TheByteAttic/CERBERUS2080/Photos/IMG_0653.jpeg

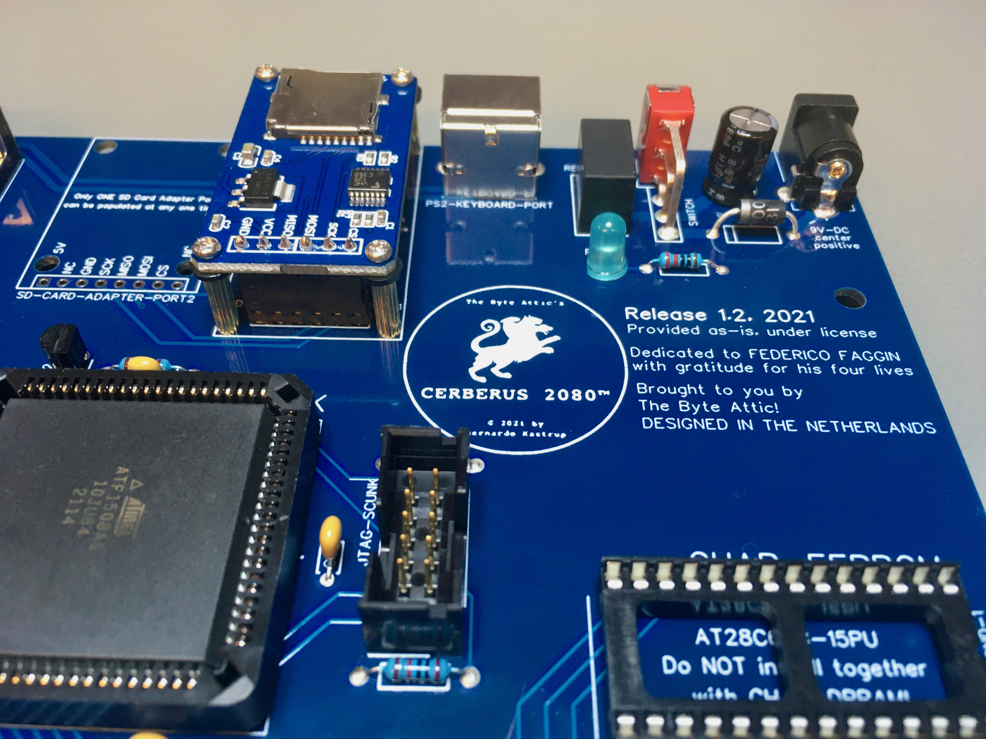
Photos/IMG_0653.jpeg
