TheByteAttic/CERBERUS2080/Photos/IMG_0697.jpg

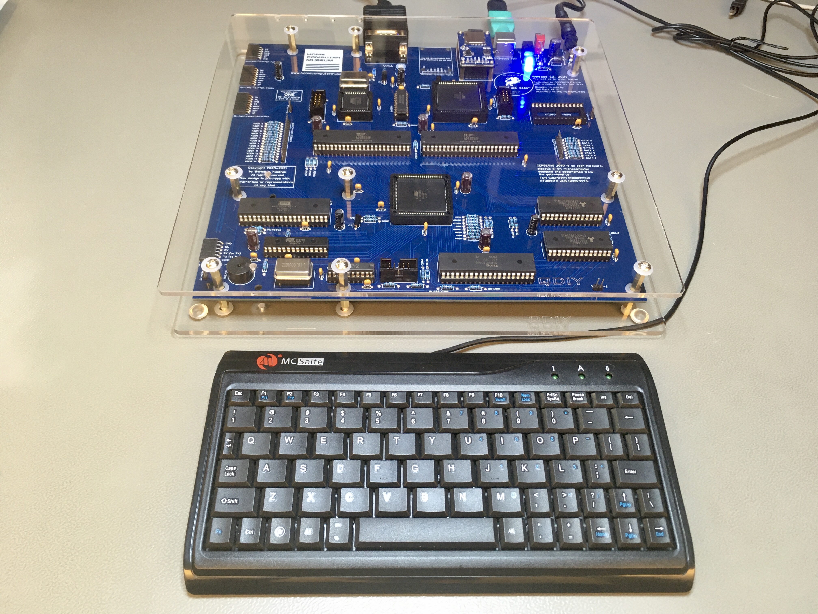
Photos/IMG_0697.jpg
