TheByteAttic/CERBERUS2080/CERBERUS Applications Source Code/README.md

This directory contains the source files (.asm) and final binary files (.bin) simple applications that runs on both of CERBERUS's CPUs (one version per CPU). 

They illustrate how to go from assembly code to binary, in a way that CERBERUS's simple loader can deal with.
