TheByteAttic/CERBERUS2080/Photos/README.md

Photos of a correctly-assembled CERBERUS, including many detail pictures. These could provide a reference for those building their own CERBERUS.
<hr>
<b>CHANGE HISTORY:</b>
<p>
<ul>
  <li><b>10 September 2021:</b> Photos of the original board (R1.0) replaced with those of the latest release (R1.2).</li>
</ul>
