TheByteAttic/CERBERUS2080/CERBERUS uSD card files/README.md

These are the files you should load into a uSD card and then insert the card into the uSD card adapter of CERBERUS 2080™ prior to powering it on.
