TheByteAttic/CERBERUS2080/Photos/IMG_0616.jpeg

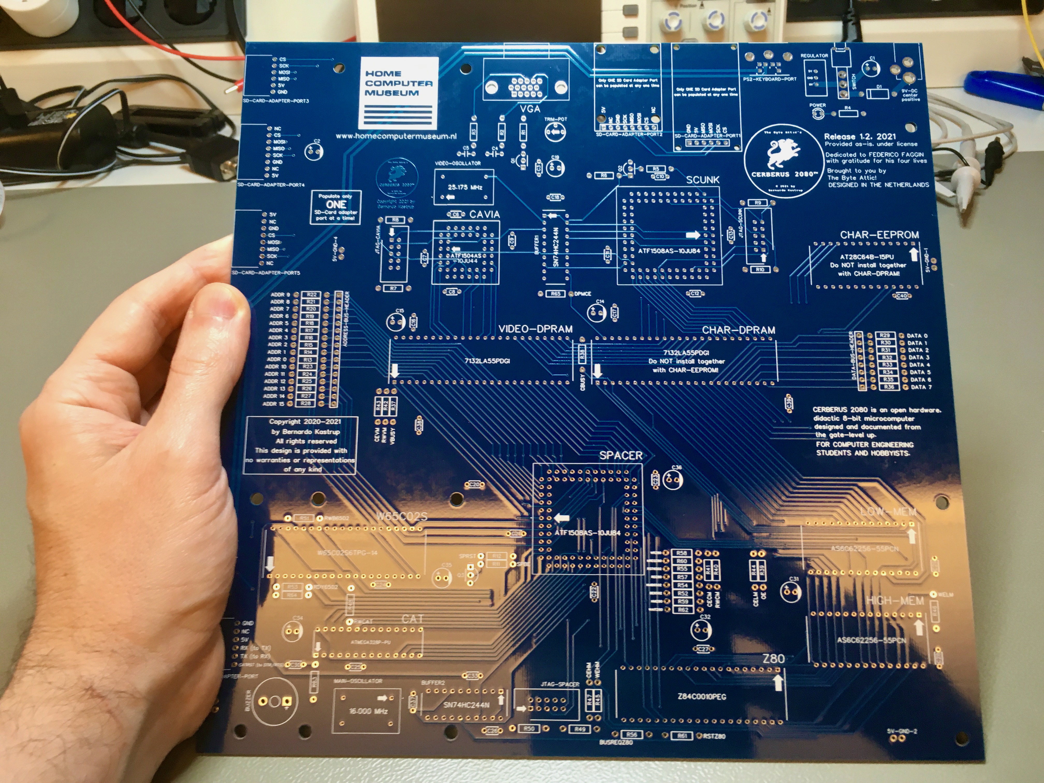
Photos/IMG_0616.jpeg
