TheByteAttic/CERBERUS2080/Photos/IMG_0617.jpeg

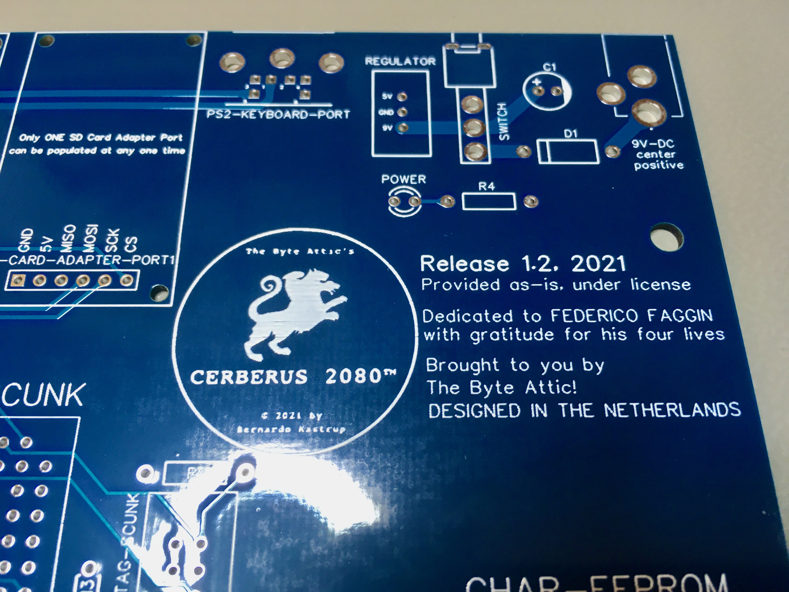
Photos/IMG_0617.jpeg
