TheByteAttic/CERBERUS2080/Photos/IMG_0618.jpeg

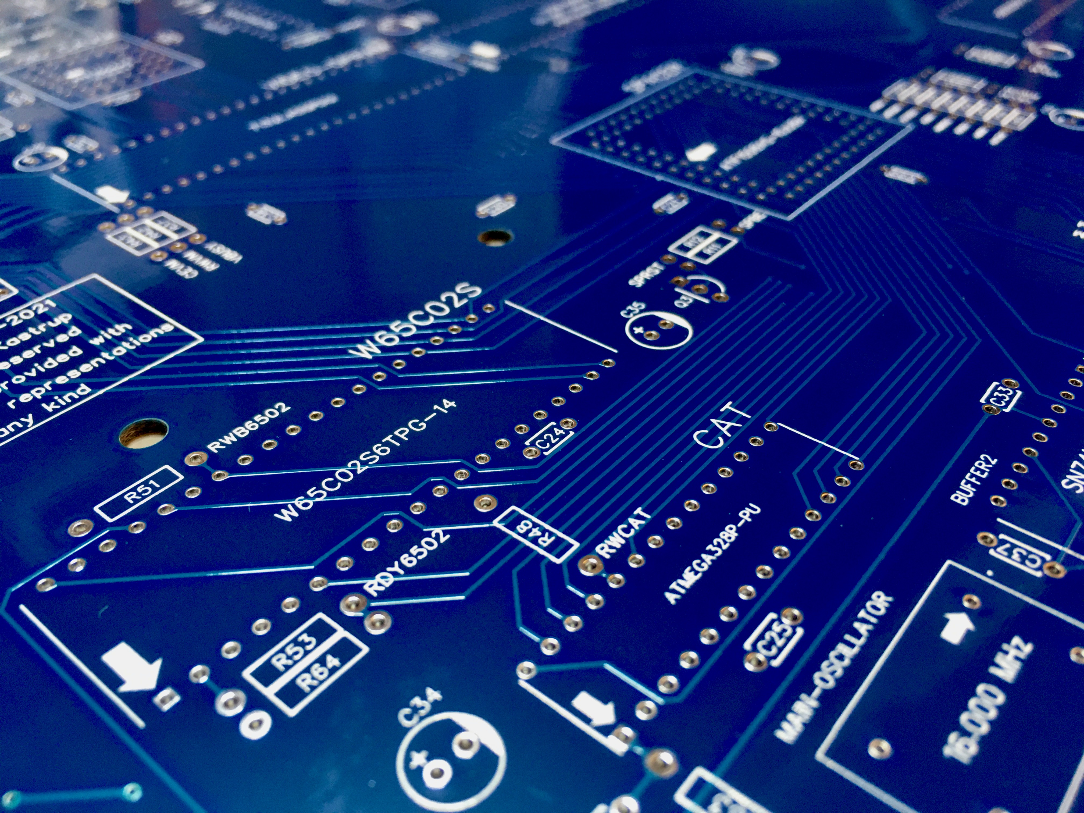
Photos/IMG_0618.jpeg
