TheByteAttic/CERBERUS2080/Photos/IMG_0619.jpeg

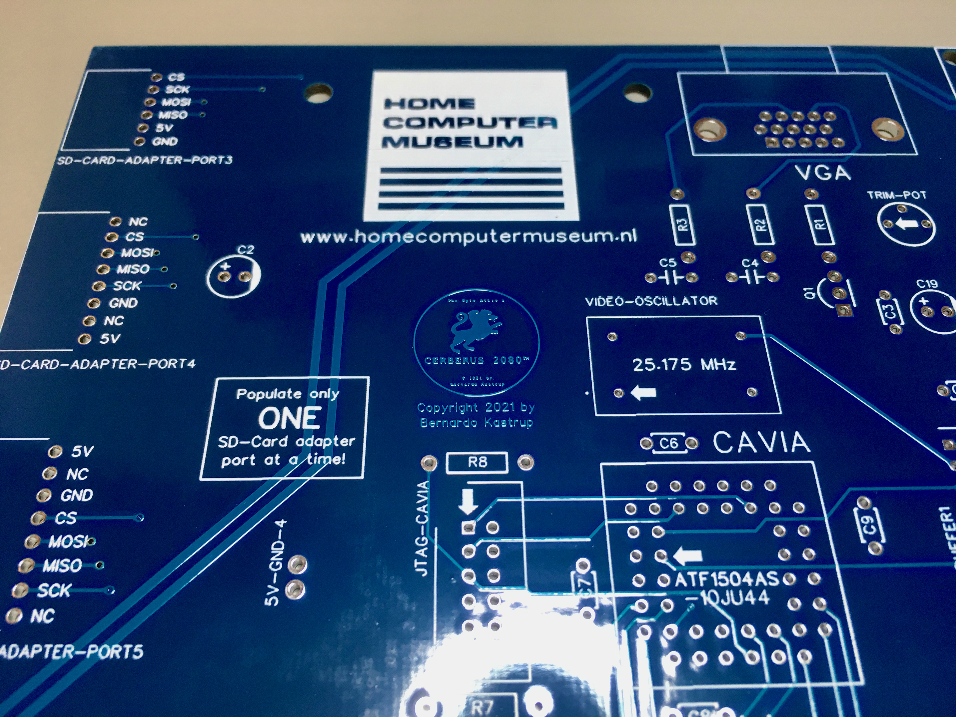
Photos/IMG_0619.jpeg
