TheByteAttic/CERBERUS2080/Photos/IMG_0620.jpeg

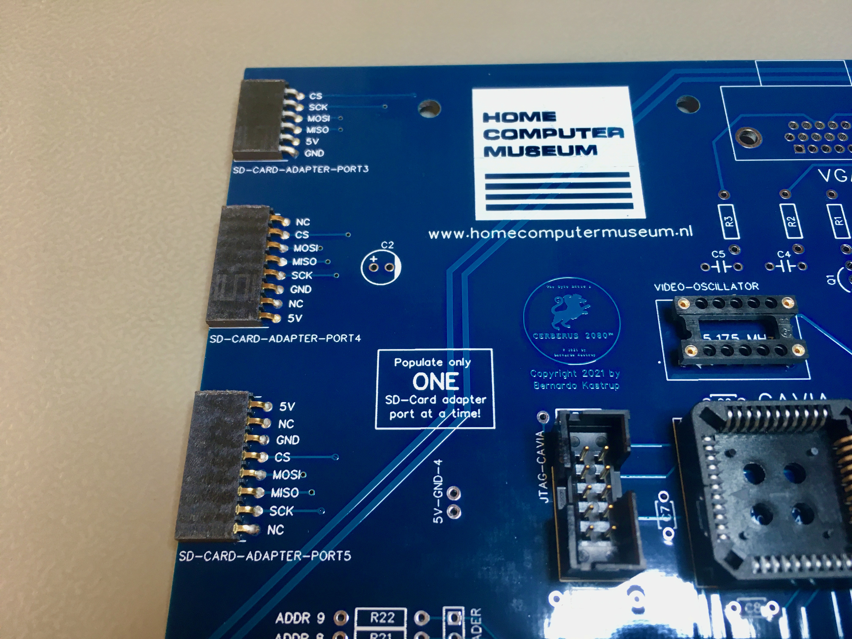
Photos/IMG_0620.jpeg
