TheByteAttic/CERBERUS2080/Photos/IMG_0621.jpeg

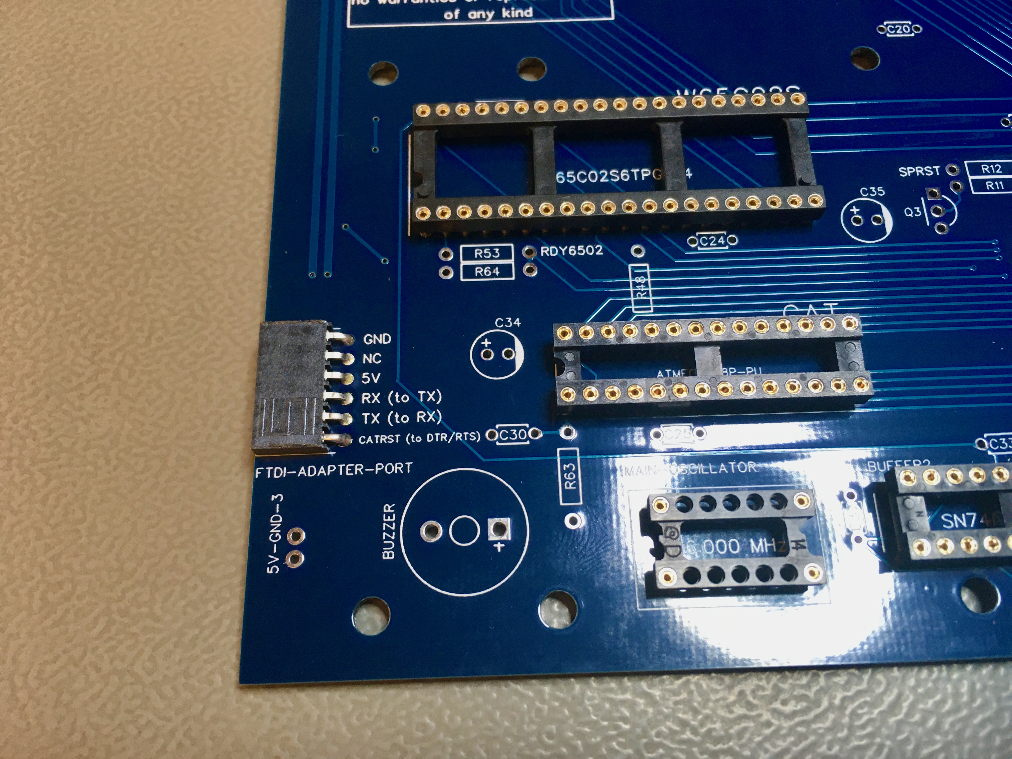
Photos/IMG_0621.jpeg
