TheByteAttic/CERBERUS2080/Photos/IMG_0622.jpeg

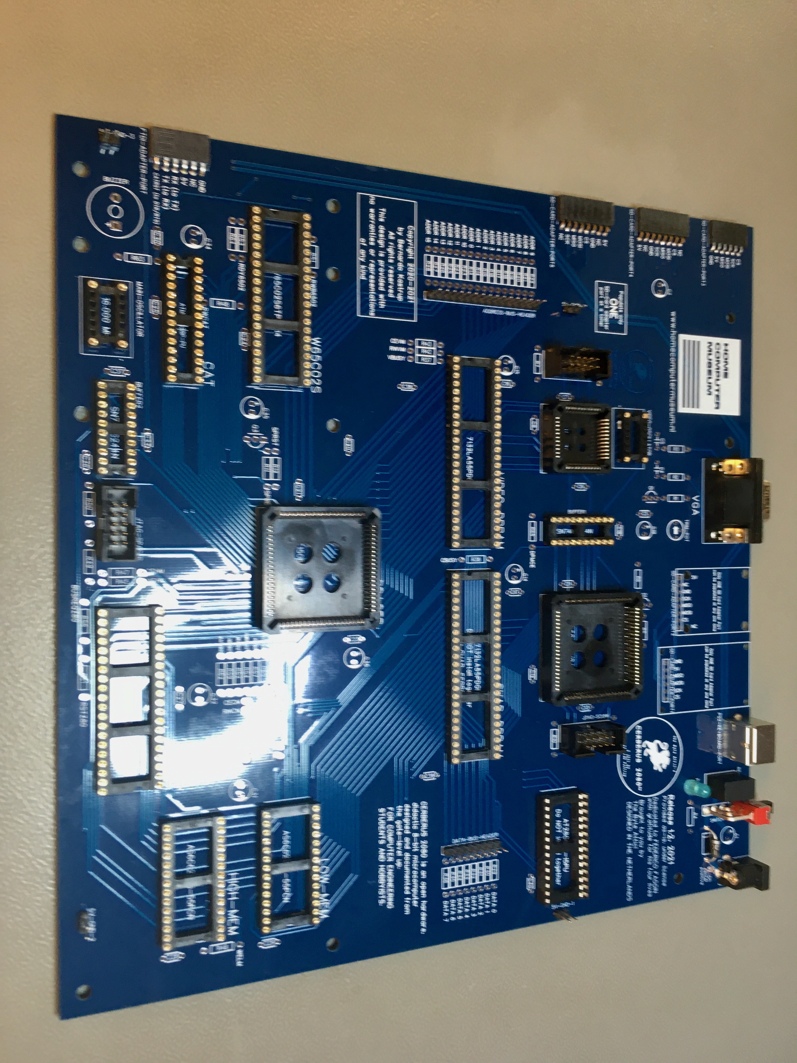
Photos/IMG_0622.jpeg
