TheByteAttic/CERBERUS2080/Photos/IMG_0623.jpeg

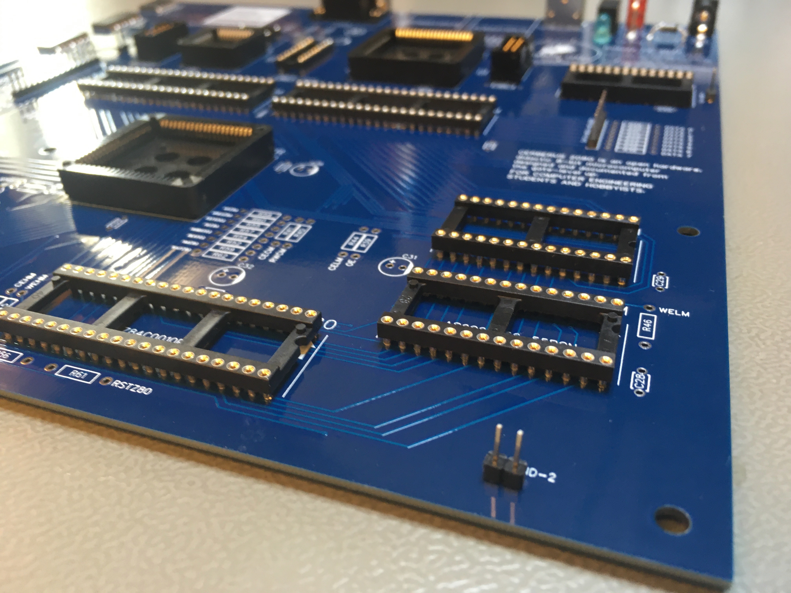
Photos/IMG_0623.jpeg
