TheByteAttic/CERBERUS2080/Photos/IMG_0627.jpeg

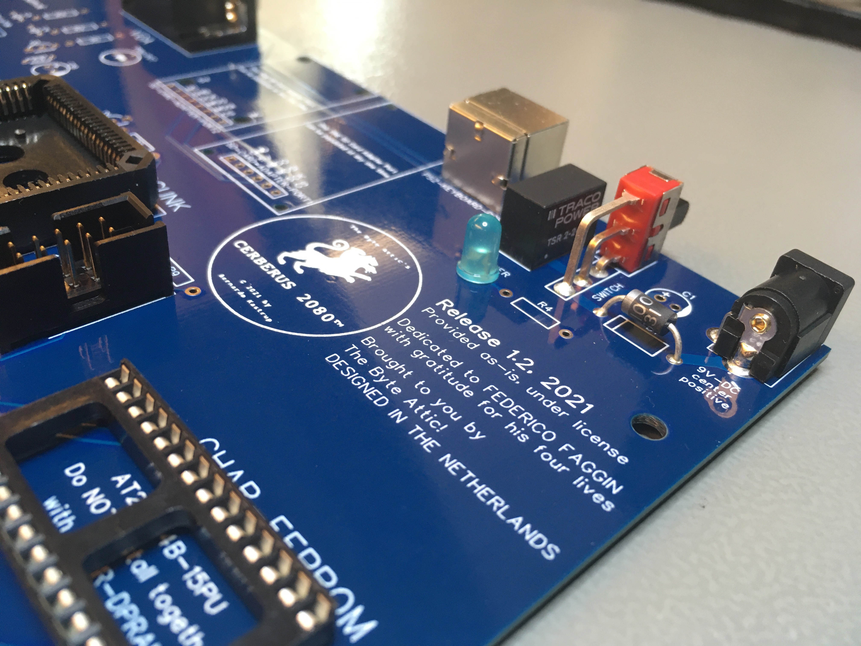
Photos/IMG_0627.jpeg
