TheByteAttic/CERBERUS2080/Photos/IMG_0628.jpeg

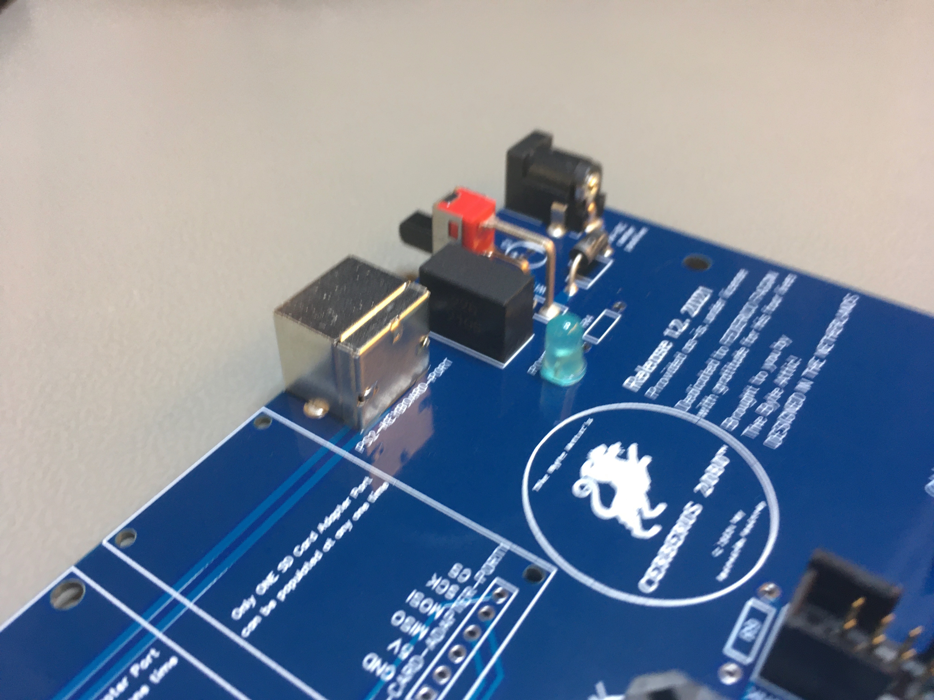
Photos/IMG_0628.jpeg
