TheByteAttic/CERBERUS2080/Photos/IMG_0629.jpeg

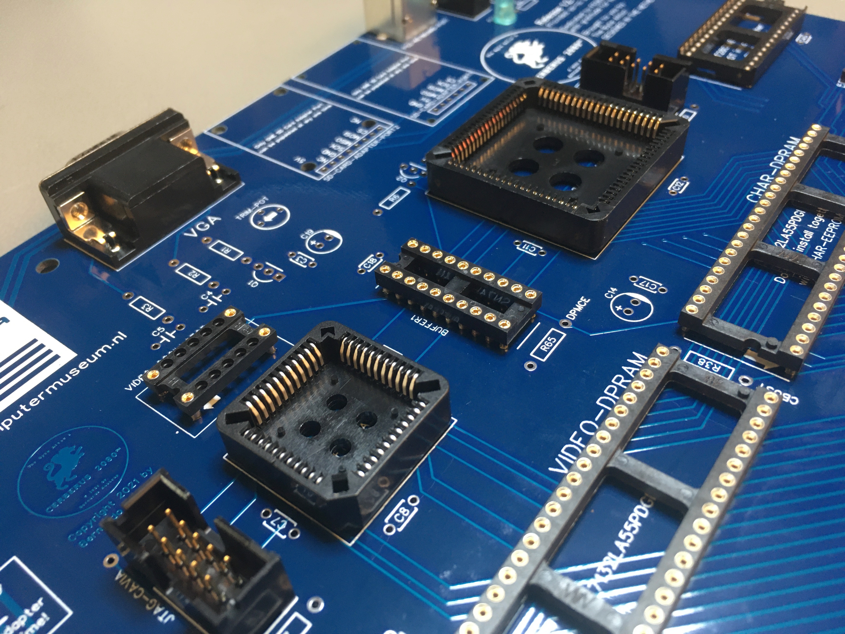
Photos/IMG_0629.jpeg
