TheByteAttic/CERBERUS2080/Photos/IMG_0630.jpeg

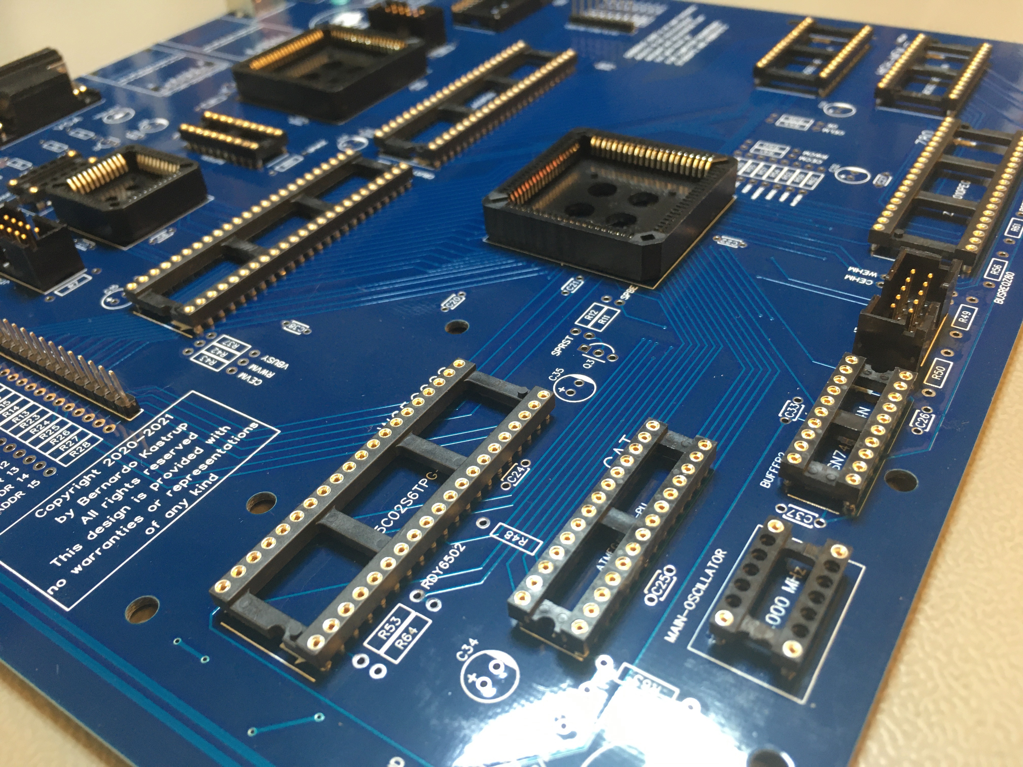
Photos/IMG_0630.jpeg
