TheByteAttic/CERBERUS2080/Photos/IMG_0631.jpeg

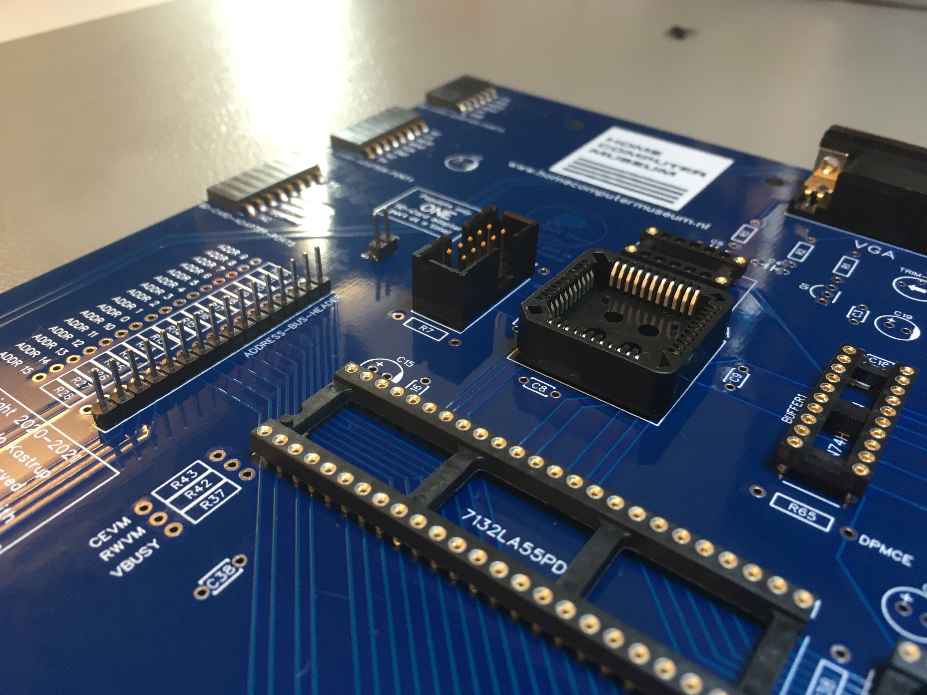
Photos/IMG_0631.jpeg
