TheByteAttic/CERBERUS2080/Photos/IMG_0632.jpeg

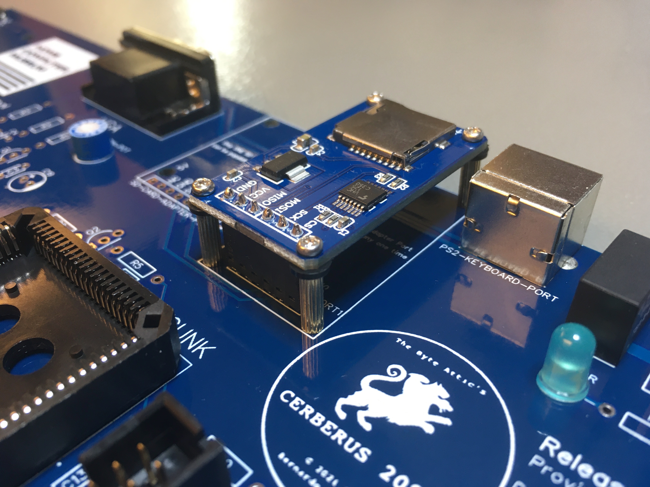
Photos/IMG_0632.jpeg
