TheByteAttic/CERBERUS2080/Photos/IMG_0633.jpeg

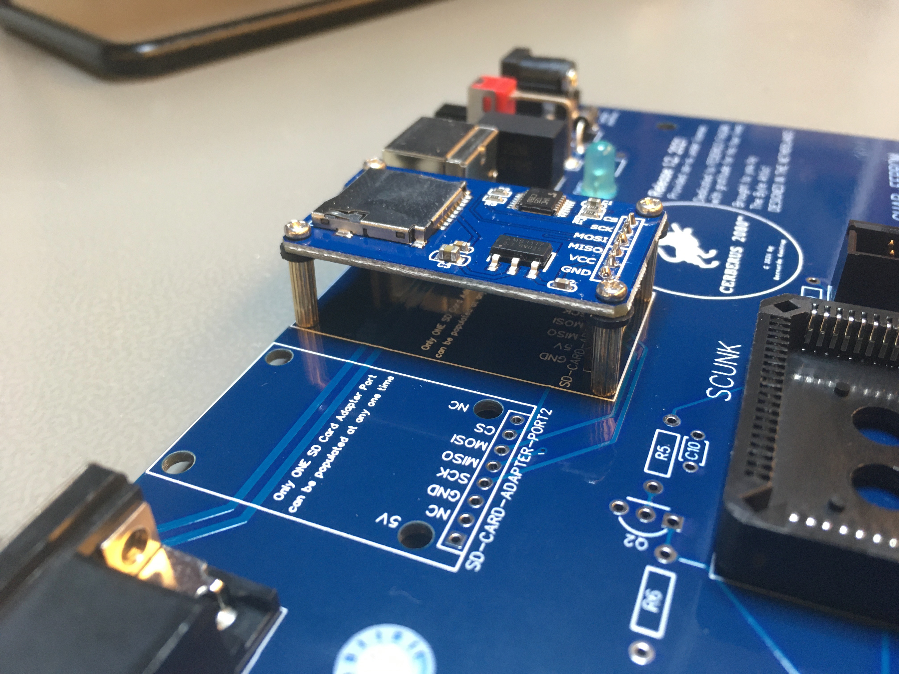
Photos/IMG_0633.jpeg
