TheByteAttic/CERBERUS2080/Photos/IMG_0634.jpeg

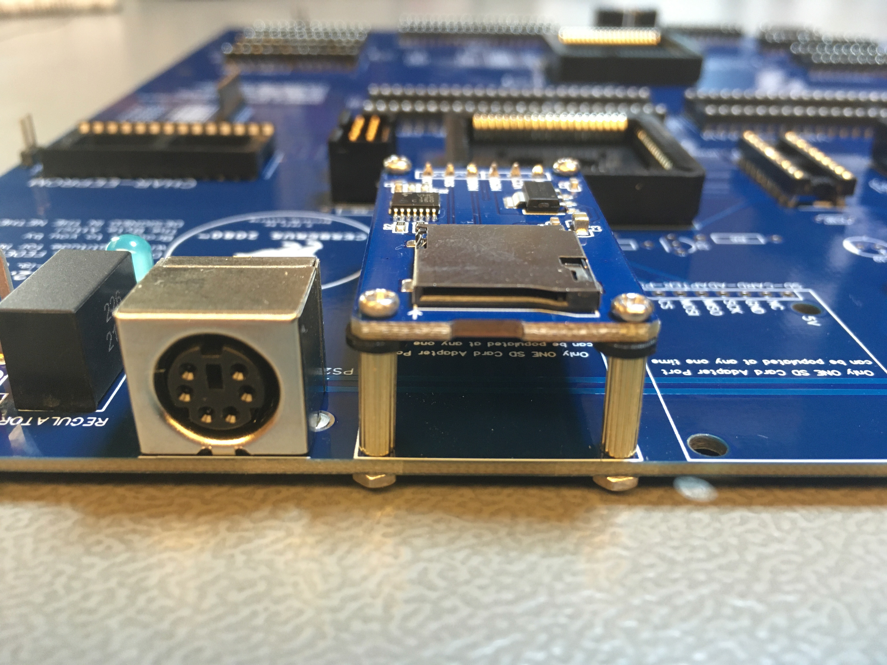
Photos/IMG_0634.jpeg
