TheByteAttic/CERBERUS2080/Photos/IMG_0635.jpeg

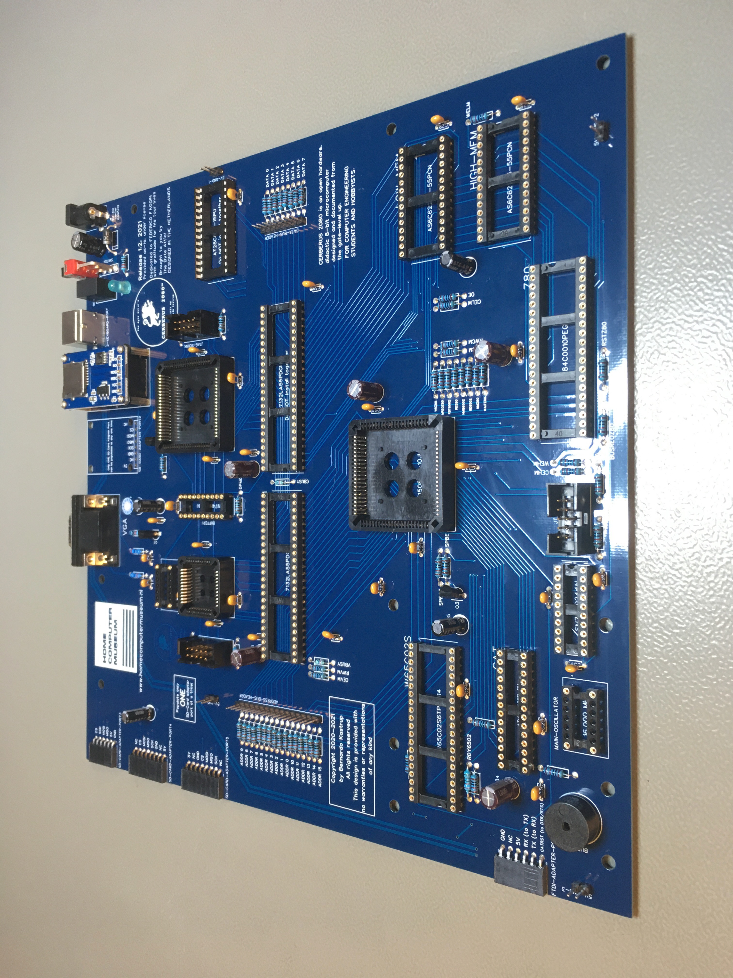
Photos/IMG_0635.jpeg
