TheByteAttic/CERBERUS2080/Photos/IMG_0636.jpeg

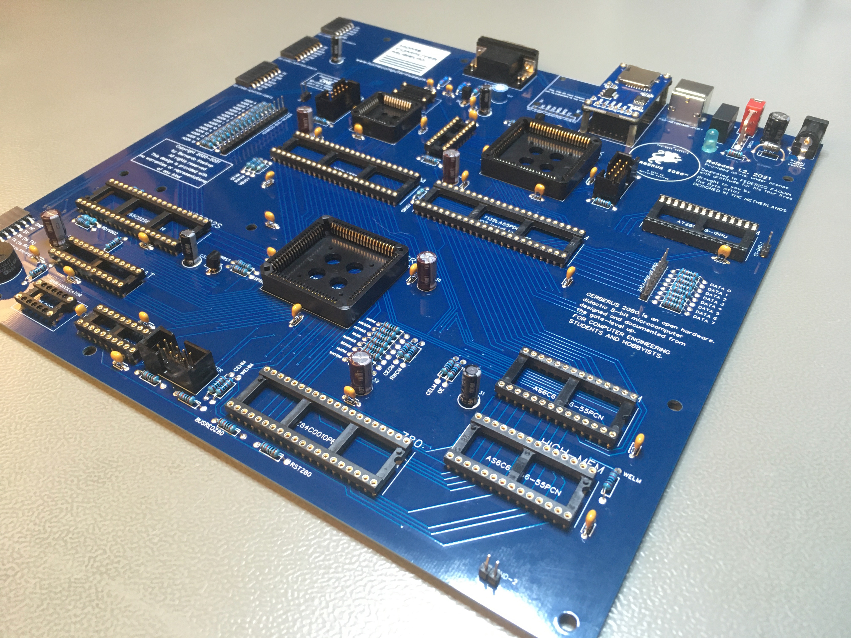
Photos/IMG_0636.jpeg
