TheByteAttic/CERBERUS2080/Photos/IMG_0637.jpeg

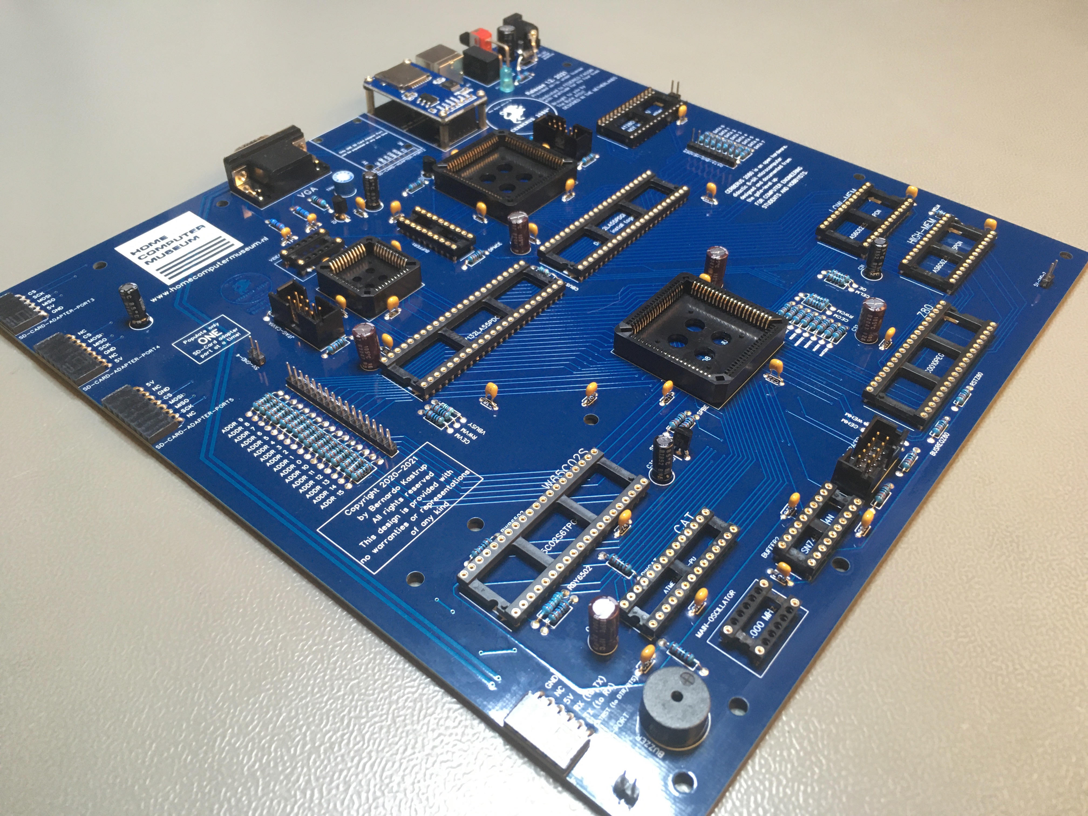
Photos/IMG_0637.jpeg
