TheByteAttic/CERBERUS2080/Photos/IMG_0638.jpeg

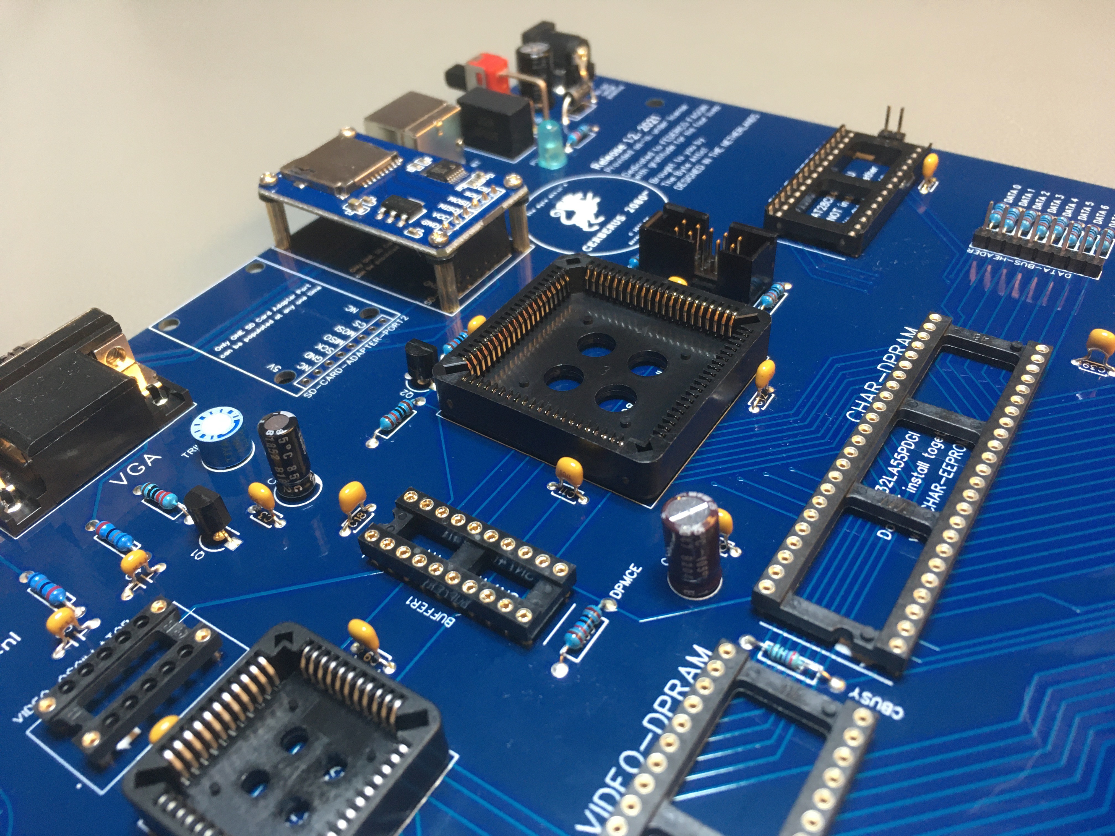
Photos/IMG_0638.jpeg
