TheByteAttic/CERBERUS2080/Photos/IMG_0639.jpeg

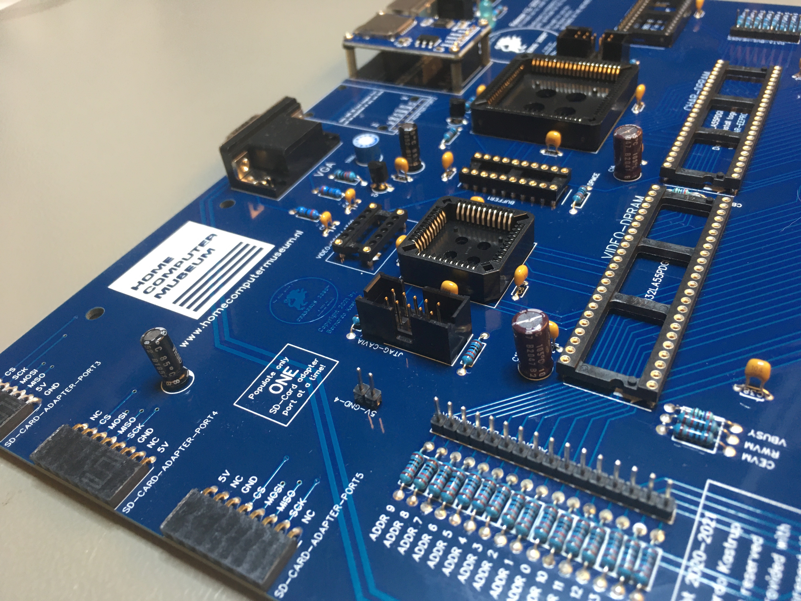
Photos/IMG_0639.jpeg
