TheByteAttic/CERBERUS2080/Photos/IMG_0640.jpeg

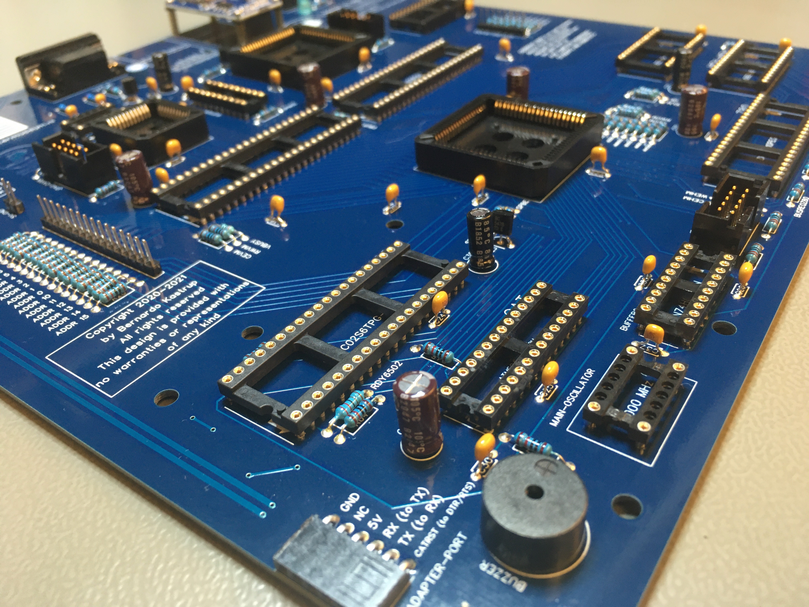
Photos/IMG_0640.jpeg
