TheByteAttic/CERBERUS2080/Photos/IMG_0641.jpeg

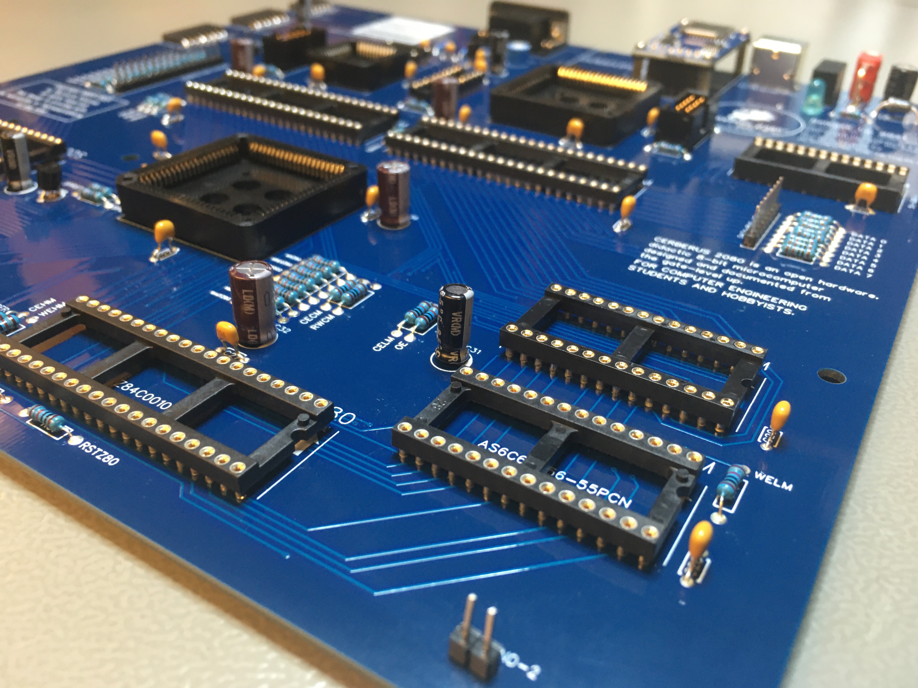
Photos/IMG_0641.jpeg
