TheByteAttic/CERBERUS2080/Photos/IMG_0642.jpeg

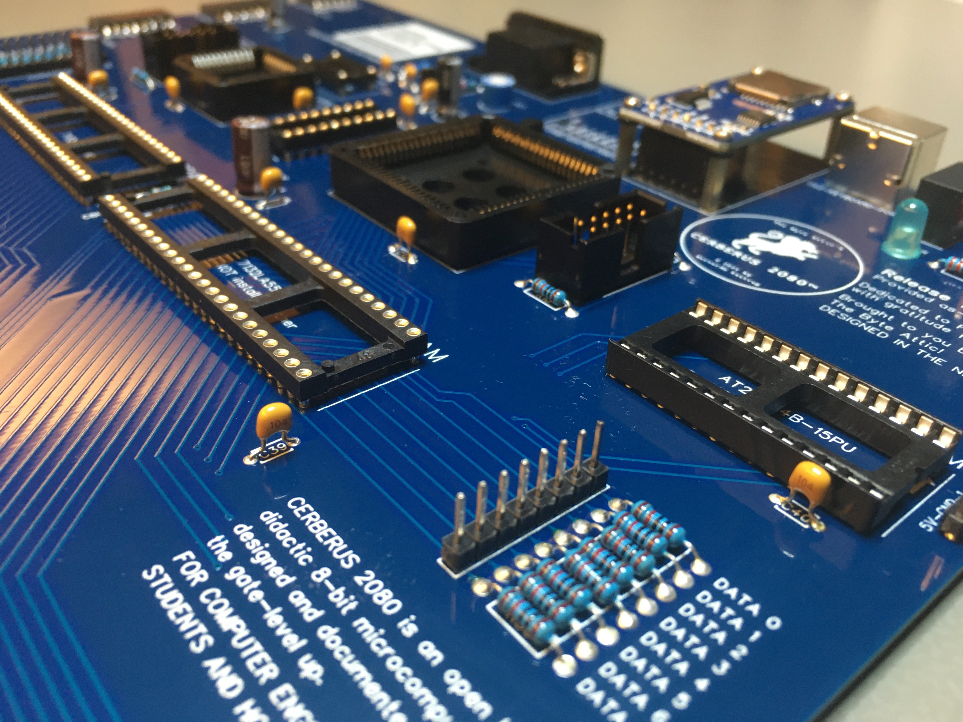
Photos/IMG_0642.jpeg
