TheByteAttic/CERBERUS2080/Photos/IMG_0643.jpeg

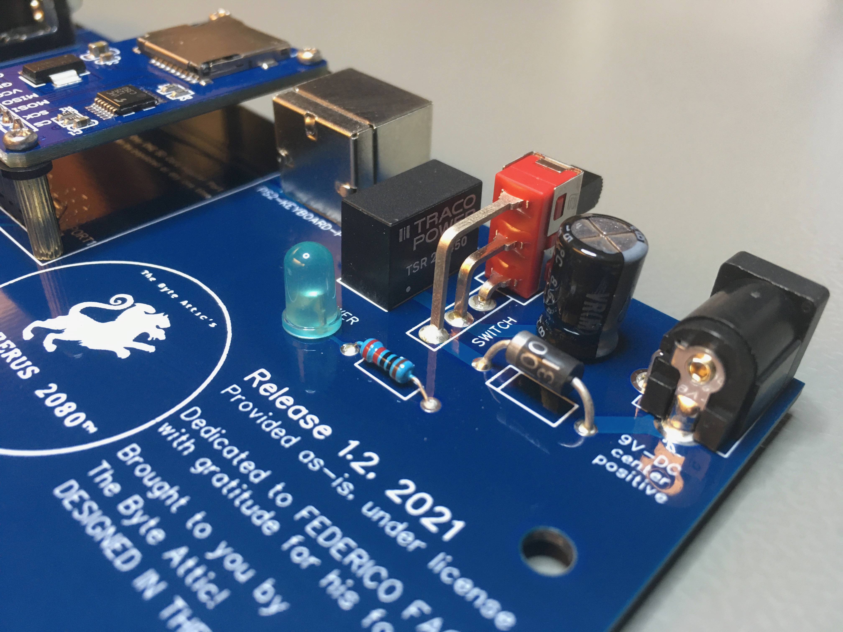
Photos/IMG_0643.jpeg
