TheByteAttic/CERBERUS2080/Photos/IMG_0644.jpeg

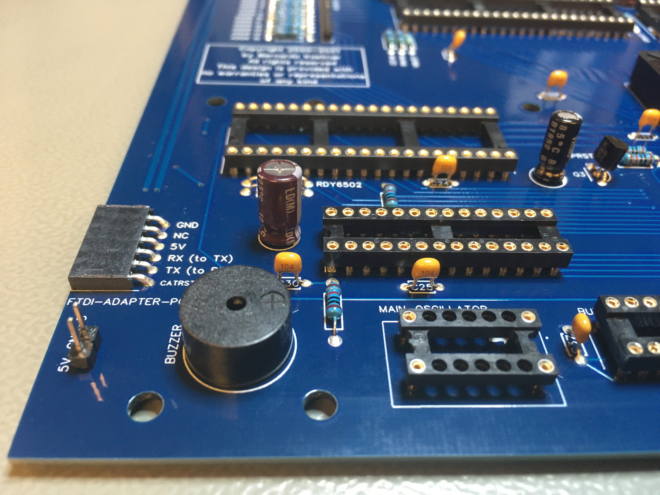
Photos/IMG_0644.jpeg
