TheByteAttic/CERBERUS2080/Photos/IMG_0645.jpeg

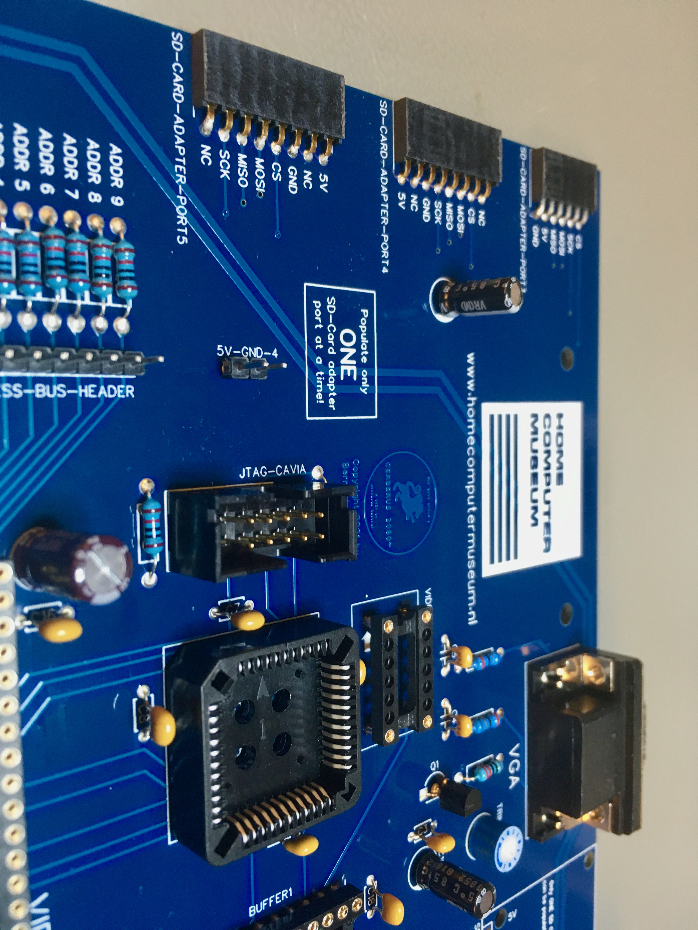
Photos/IMG_0645.jpeg
