TheByteAttic/CERBERUS2080/Photos/IMG_0646.jpeg

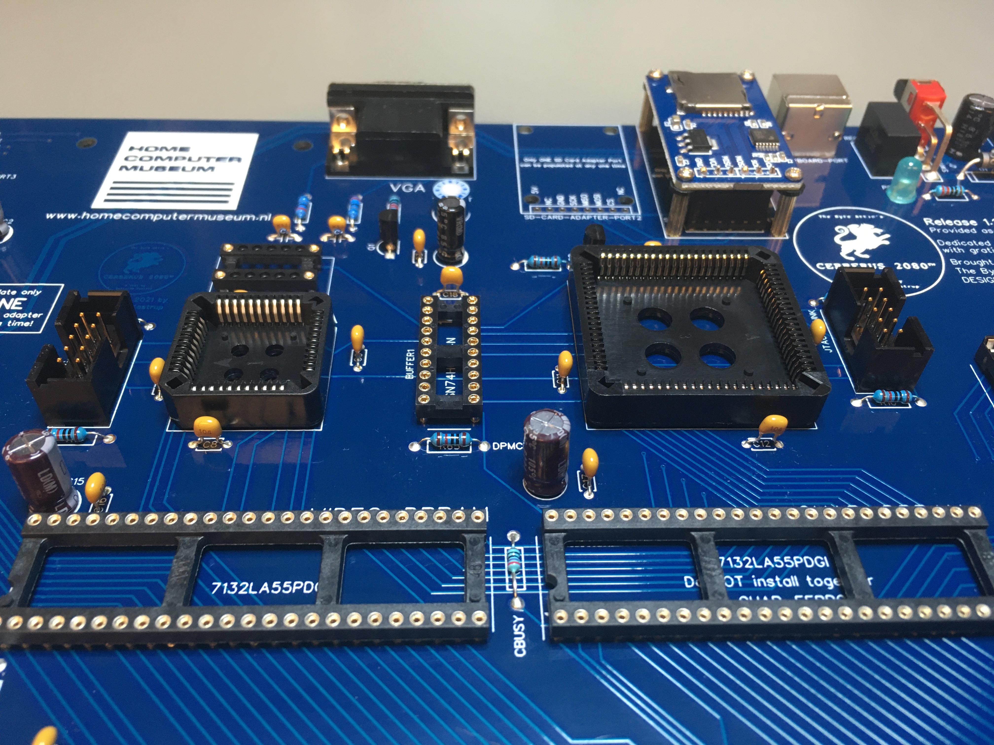
Photos/IMG_0646.jpeg
