TheByteAttic/CERBERUS2080/Photos/IMG_0647.jpeg

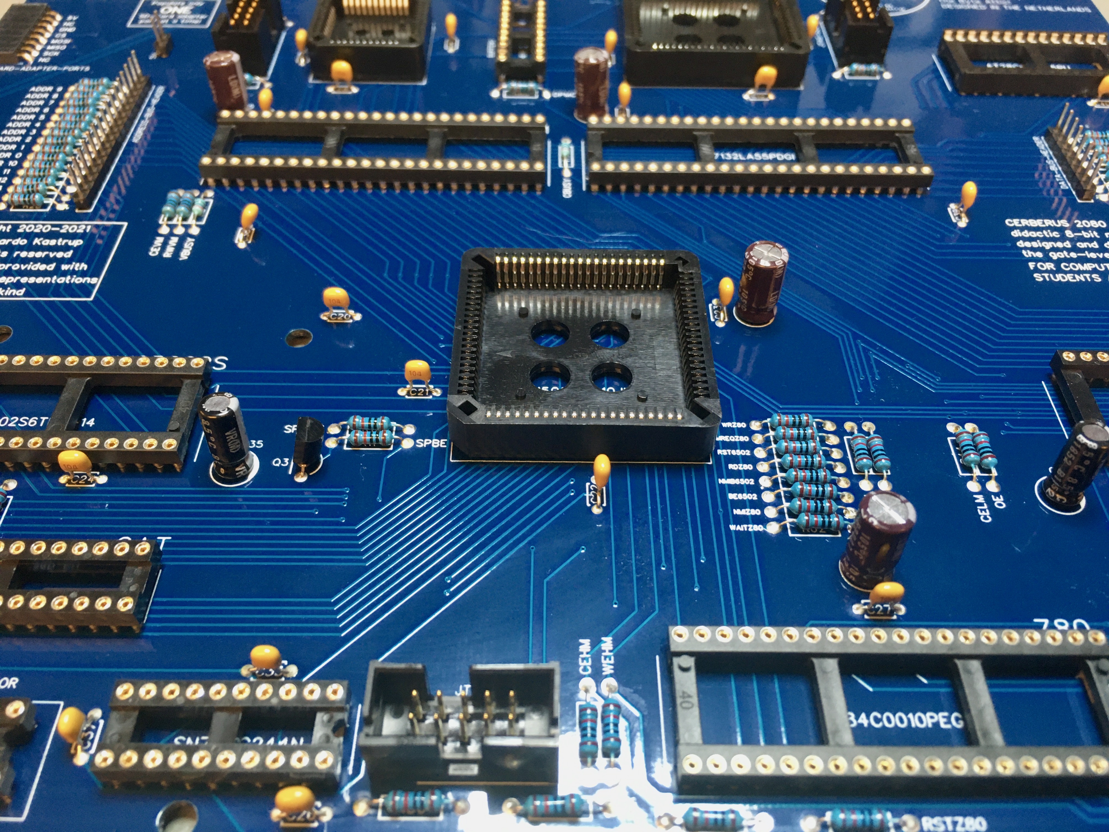
Photos/IMG_0647.jpeg
