TheByteAttic/CERBERUS2080/Photos/IMG_0648.jpeg

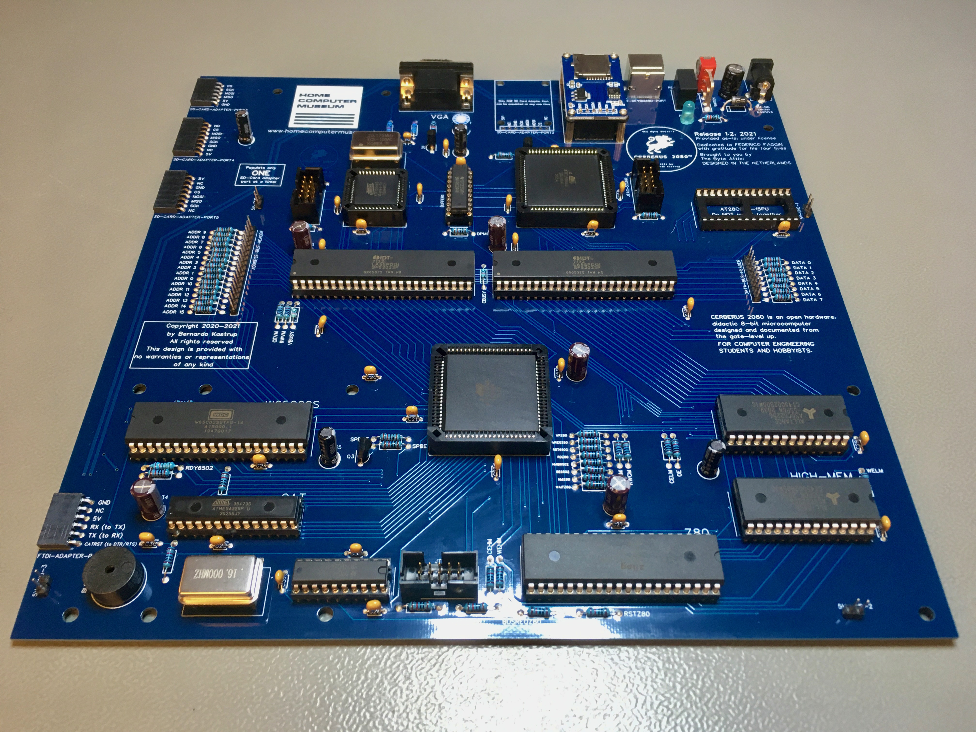
Photos/IMG_0648.jpeg
