TheByteAttic/CERBERUS2080/Photos/IMG_0649.jpeg

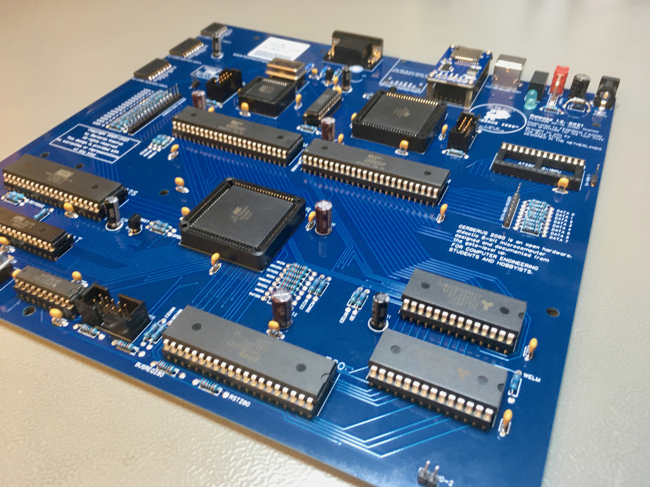
Photos/IMG_0649.jpeg
