TheByteAttic/CERBERUS2080/Photos/IMG_0650.jpeg

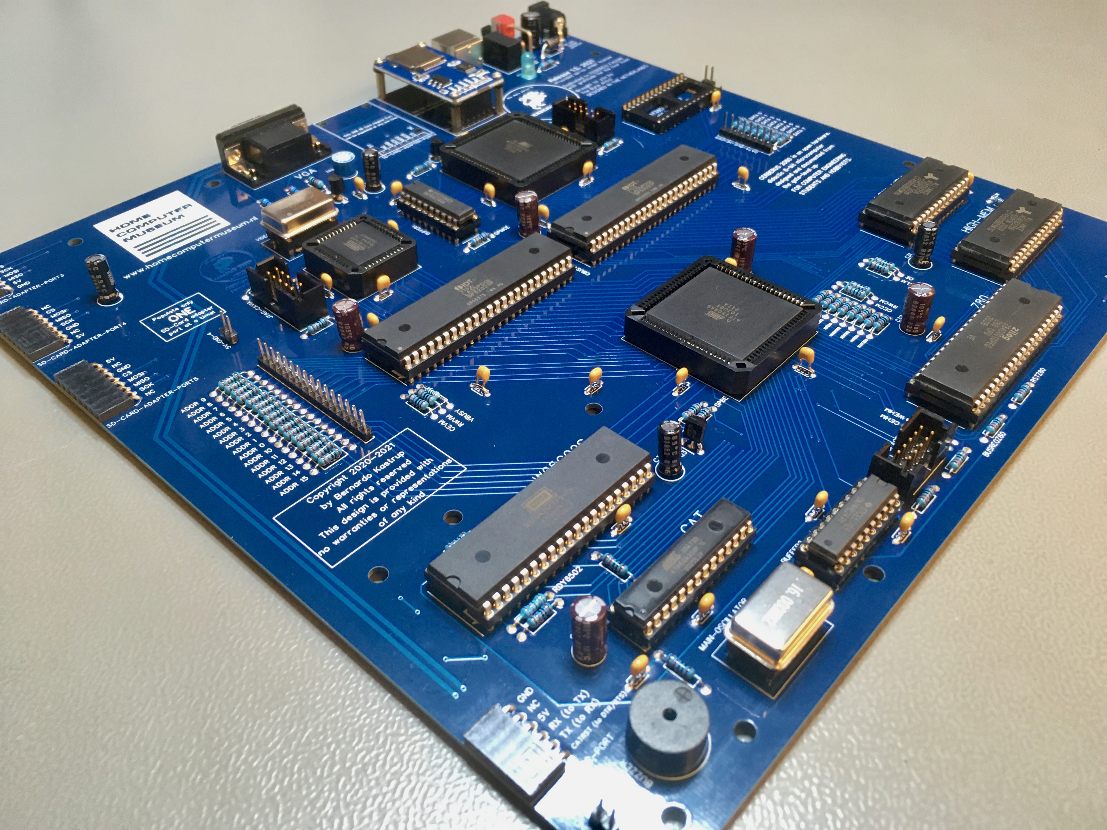
Photos/IMG_0650.jpeg
