TheByteAttic/CERBERUS2080/Photos/IMG_0651.jpeg

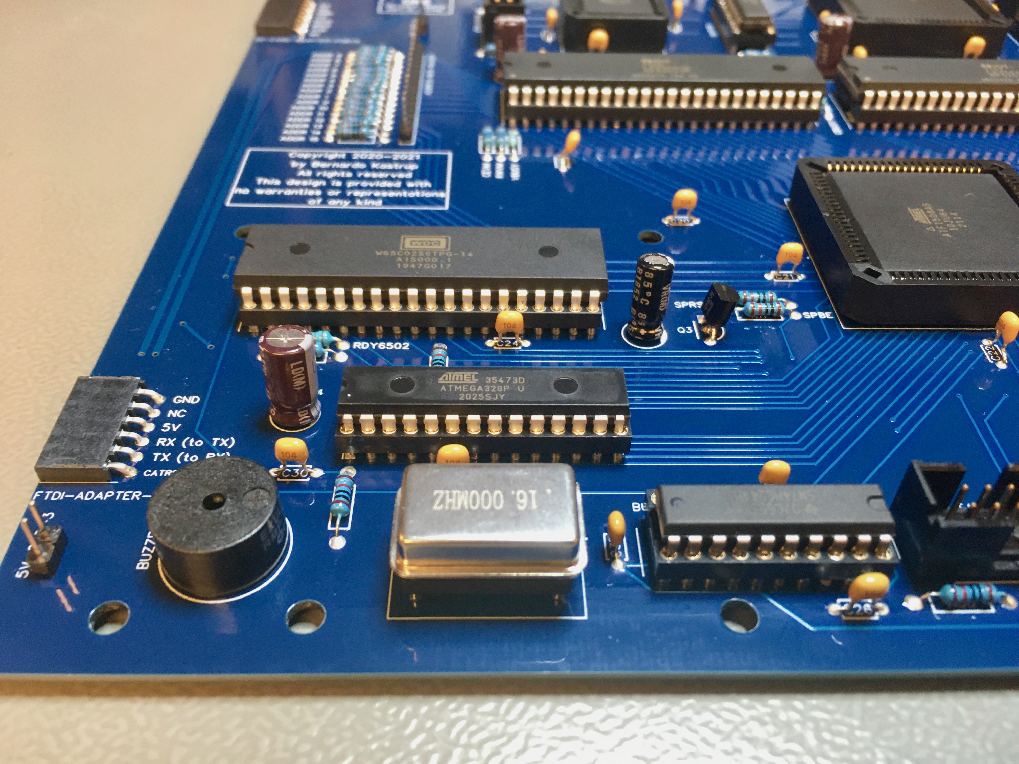
Photos/IMG_0651.jpeg
