TheByteAttic/CERBERUS2080/Photos/IMG_0652.jpeg

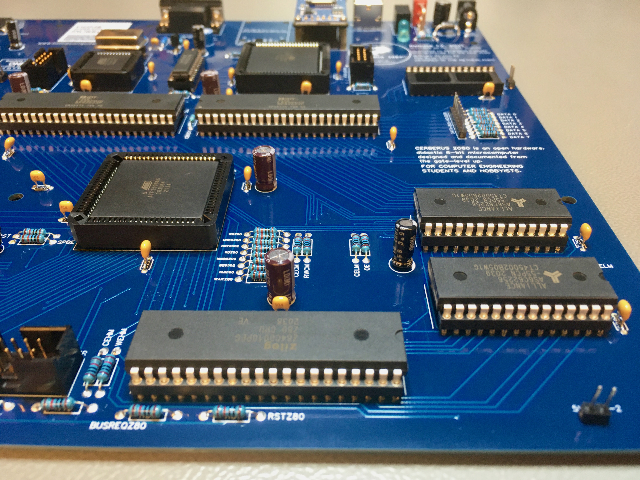
Photos/IMG_0652.jpeg
