TheByteAttic/CERBERUS2080/Photos/IMG_0654.jpeg

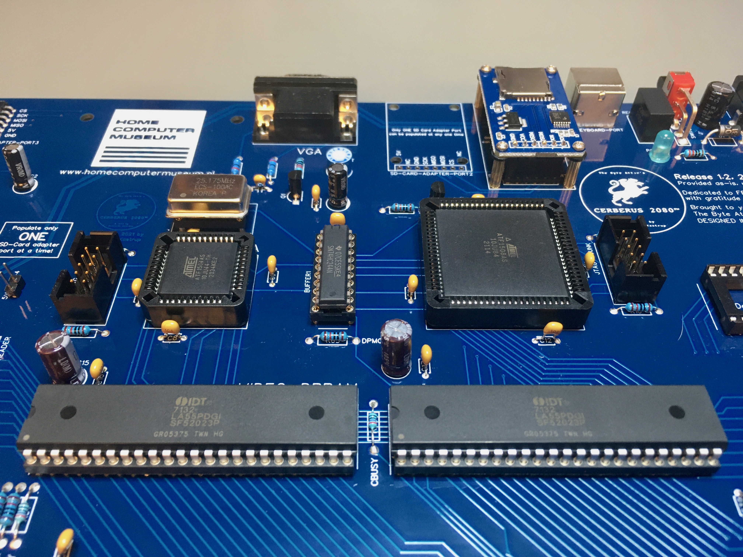
Photos/IMG_0654.jpeg
