TheByteAttic/CERBERUS2080/Photos/IMG_0655.jpeg

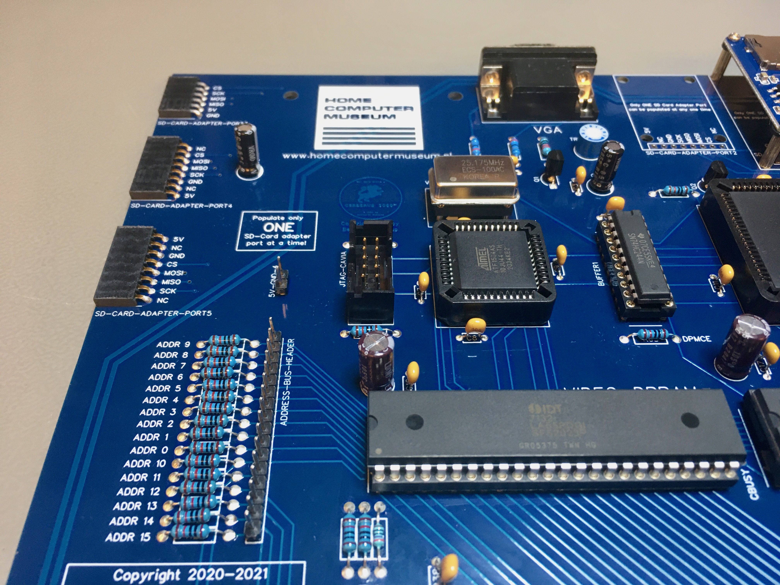
Photos/IMG_0655.jpeg
