TheByteAttic/CERBERUS2080/Photos/IMG_0656.jpeg

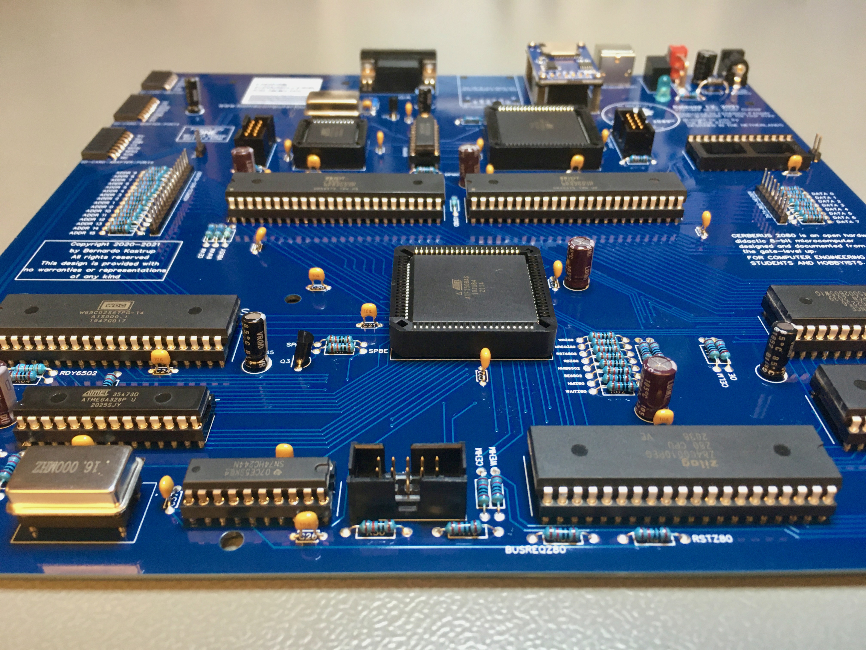
Photos/IMG_0656.jpeg
