TheByteAttic/CERBERUS2080/Photos/IMG_0657.jpeg

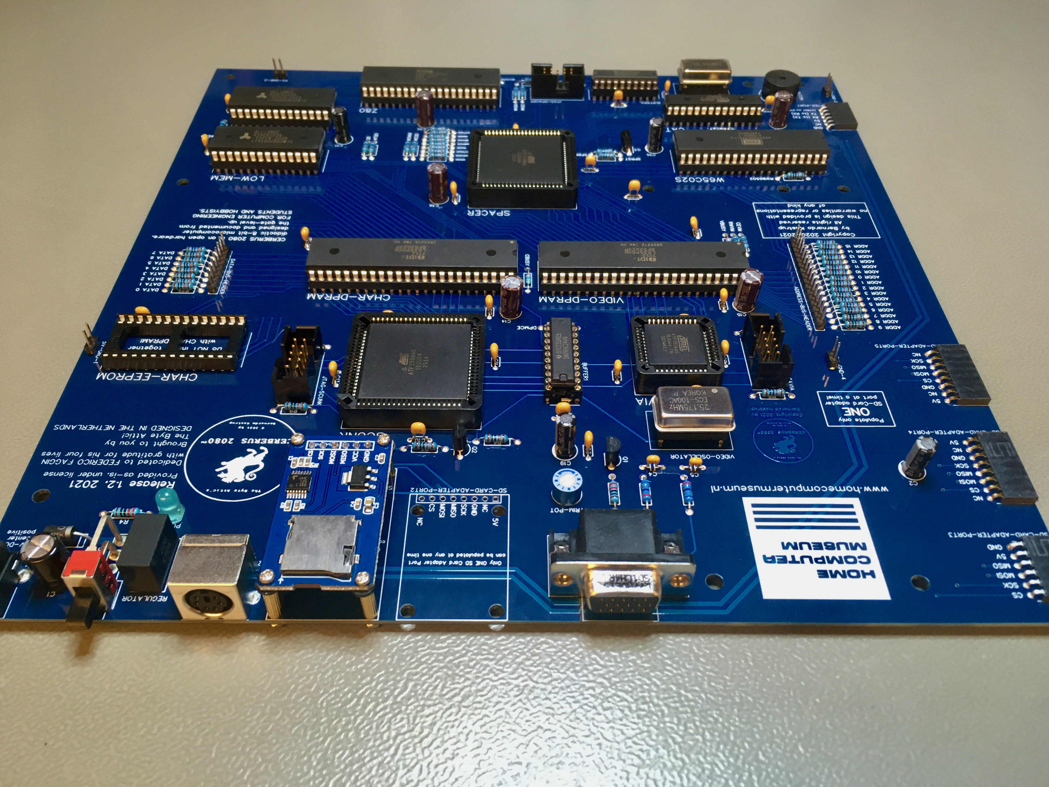
Photos/IMG_0657.jpeg
