TheByteAttic/CERBERUS2080/Photos/IMG_0658.jpeg

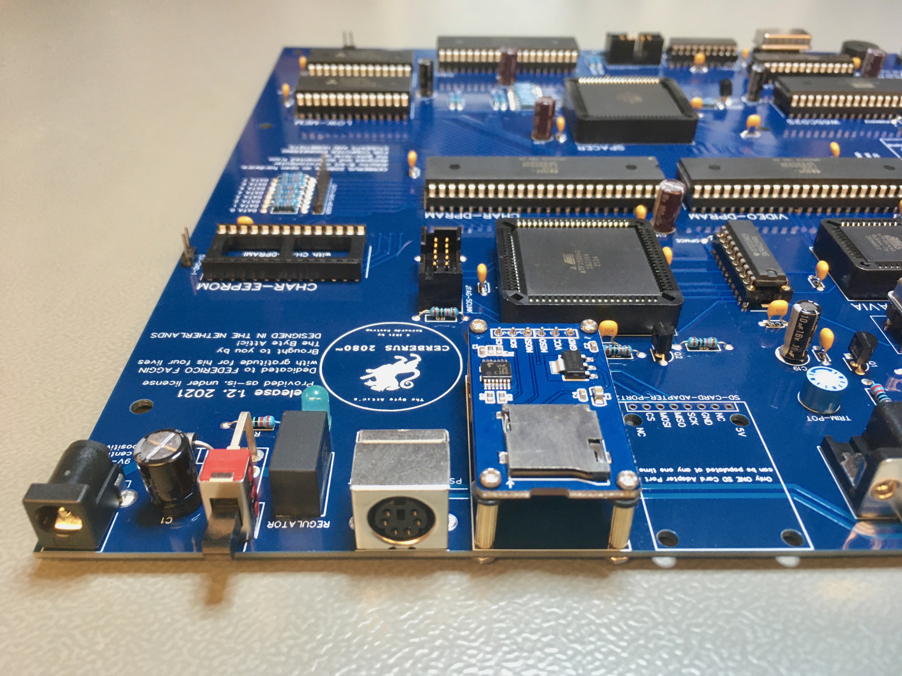
Photos/IMG_0658.jpeg
