TheByteAttic/CERBERUS2080/Photos/IMG_0659.jpeg

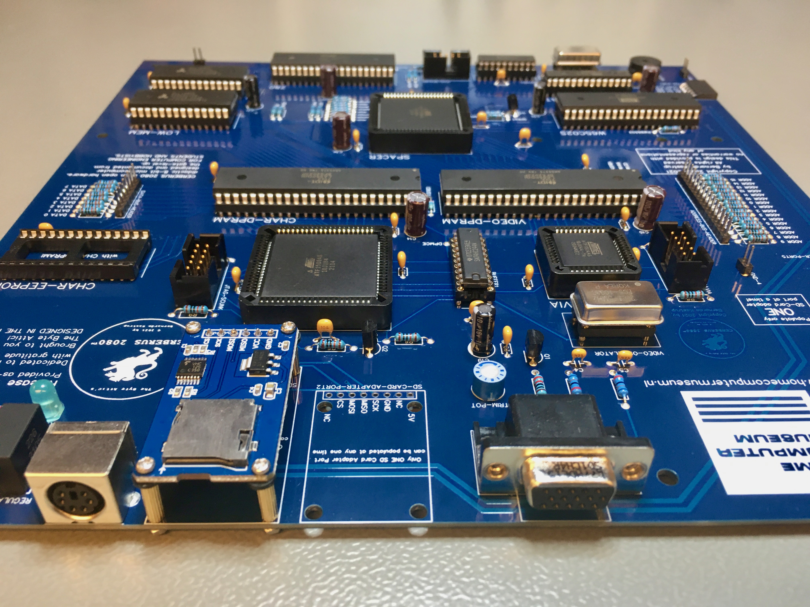
Photos/IMG_0659.jpeg
