TheByteAttic/CERBERUS2080/Photos/IMG_0660.jpeg

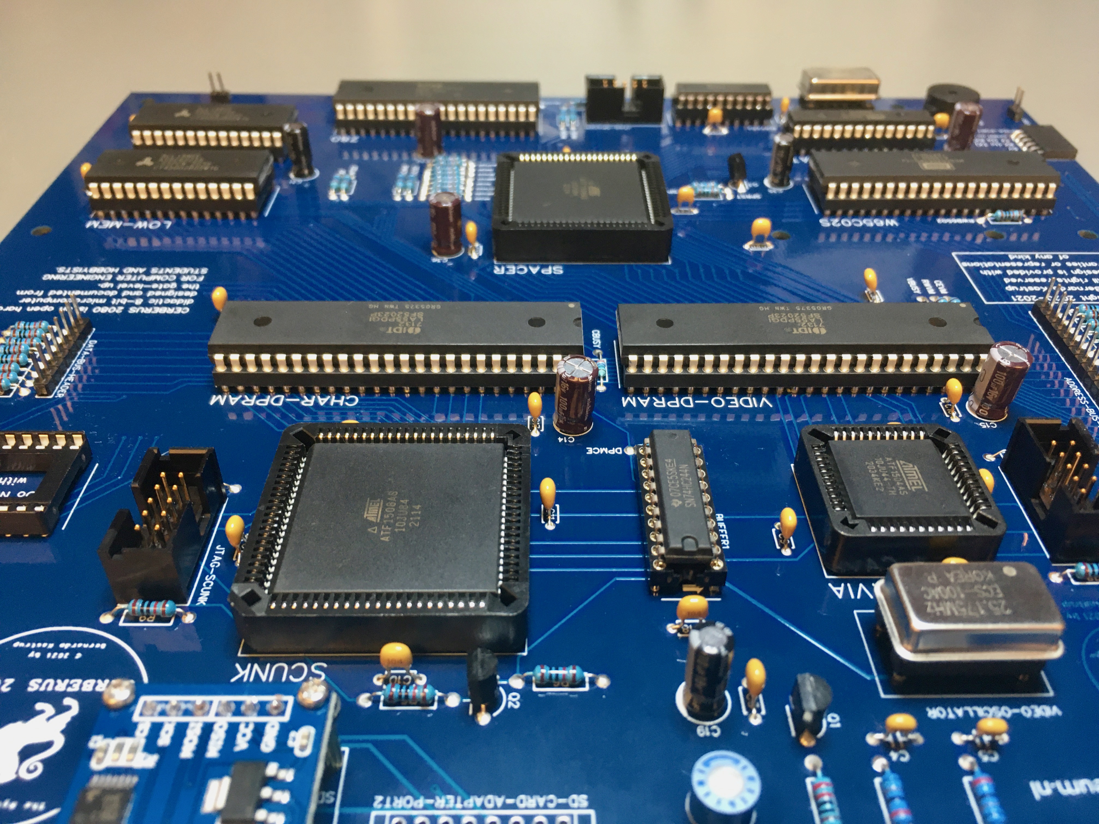
Photos/IMG_0660.jpeg
