TheByteAttic/CERBERUS2080/Photos/IMG_0661.jpeg

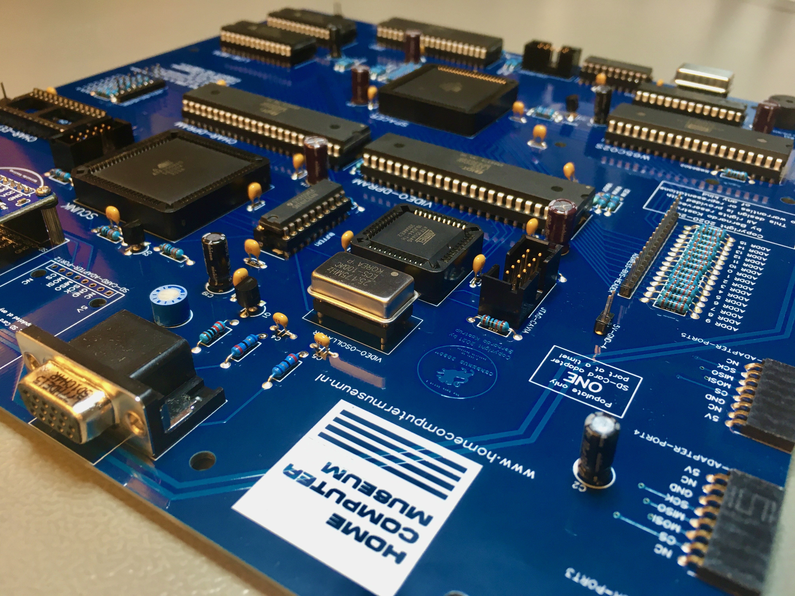
Photos/IMG_0661.jpeg
