TheByteAttic/CERBERUS2080/Photos/IMG_0662.jpeg

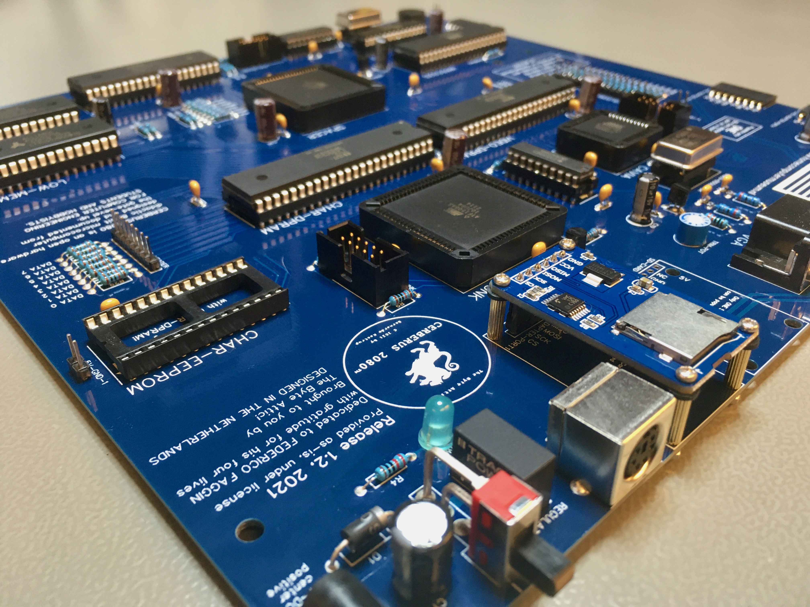
Photos/IMG_0662.jpeg
