TheByteAttic/CERBERUS2080/Photos/IMG_0663.jpeg

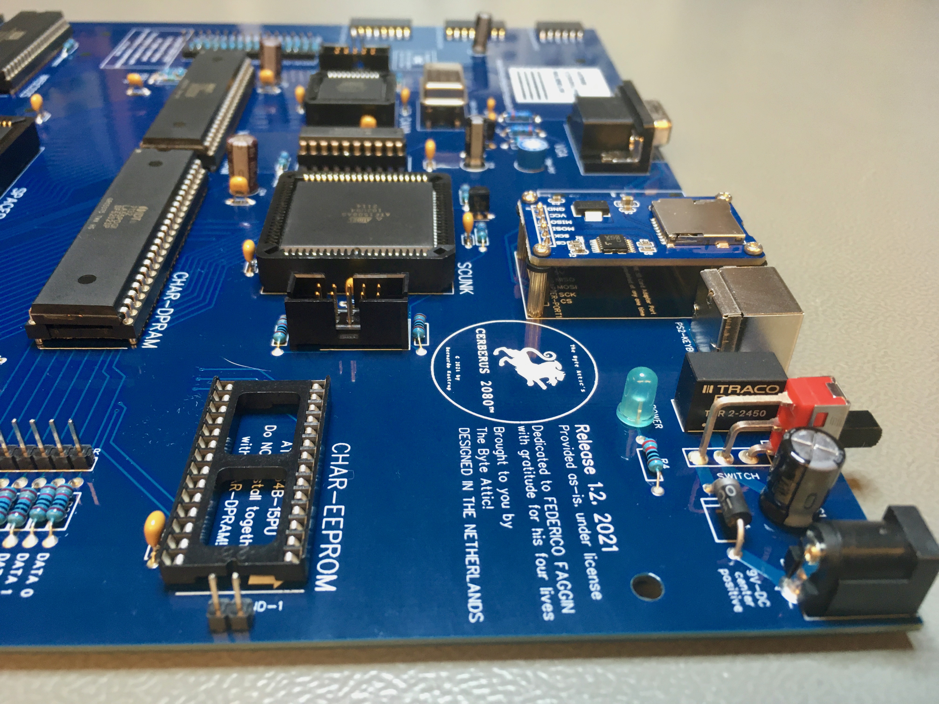
Photos/IMG_0663.jpeg
