TheByteAttic/CERBERUS2080/Photos/IMG_0664.jpeg

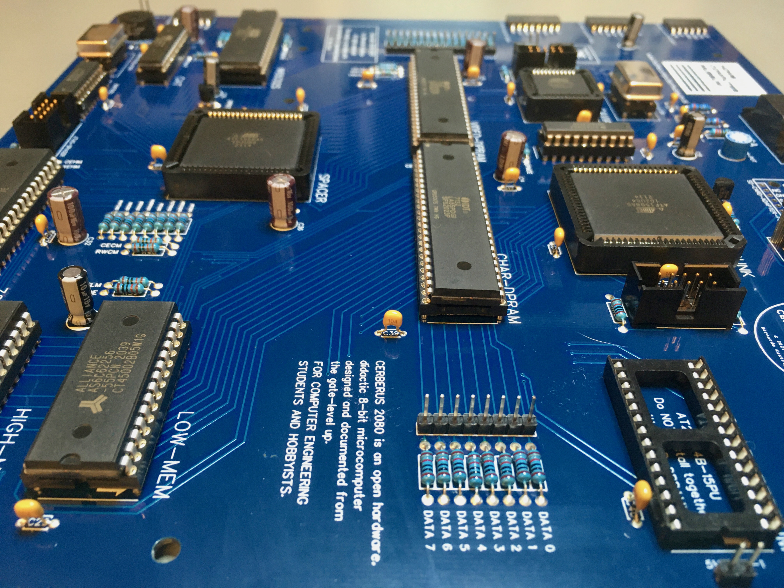
Photos/IMG_0664.jpeg
