TheByteAttic/CERBERUS2080/Photos/IMG_0665.jpeg

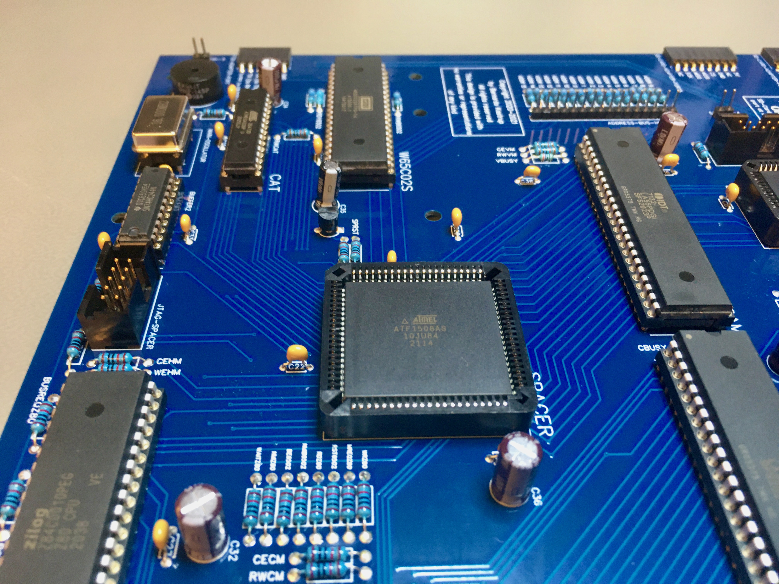
Photos/IMG_0665.jpeg
