TheByteAttic/CERBERUS2080/Photos/IMG_0666.jpeg

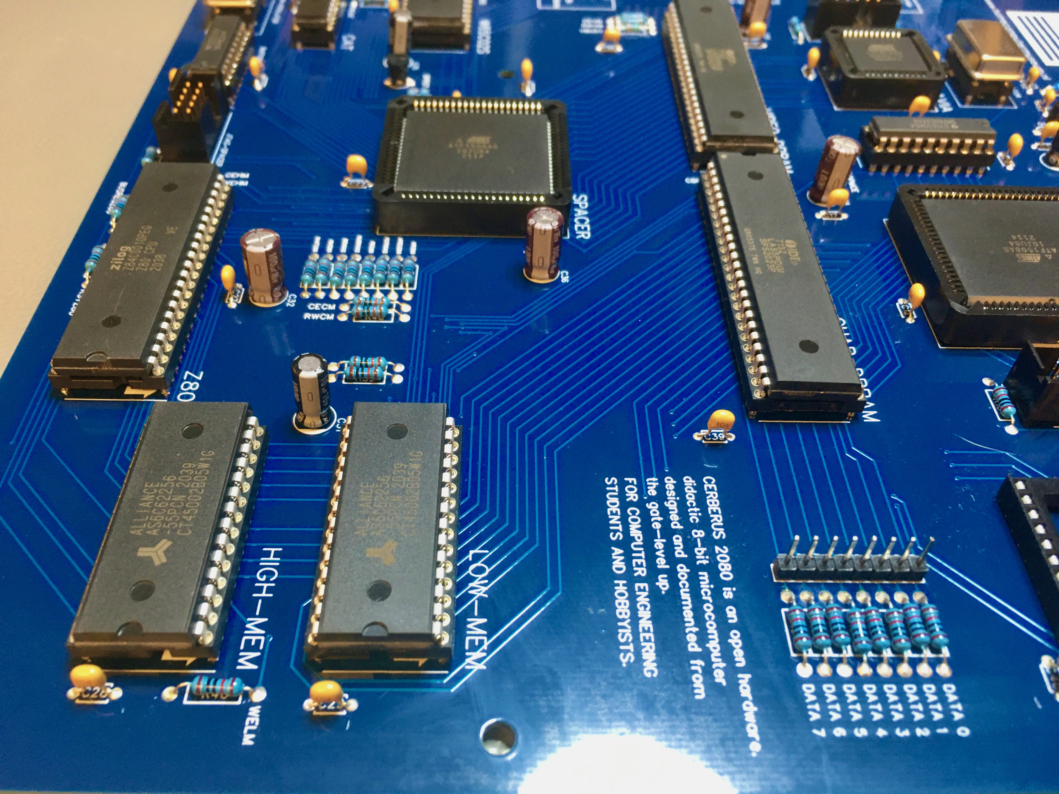
Photos/IMG_0666.jpeg
