TheByteAttic/CERBERUS2080/Photos/IMG_0667.jpeg

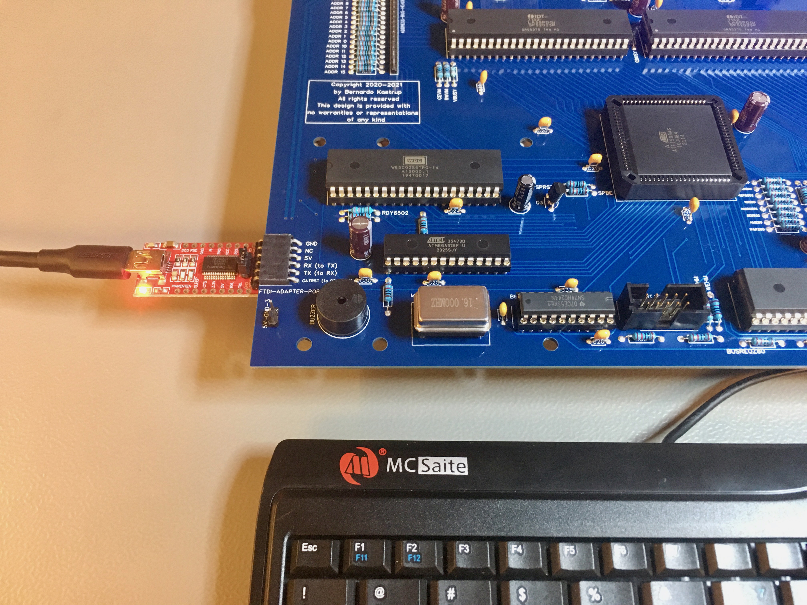
Photos/IMG_0667.jpeg
