TheByteAttic/CERBERUS2080/Photos/IMG_0669.jpeg

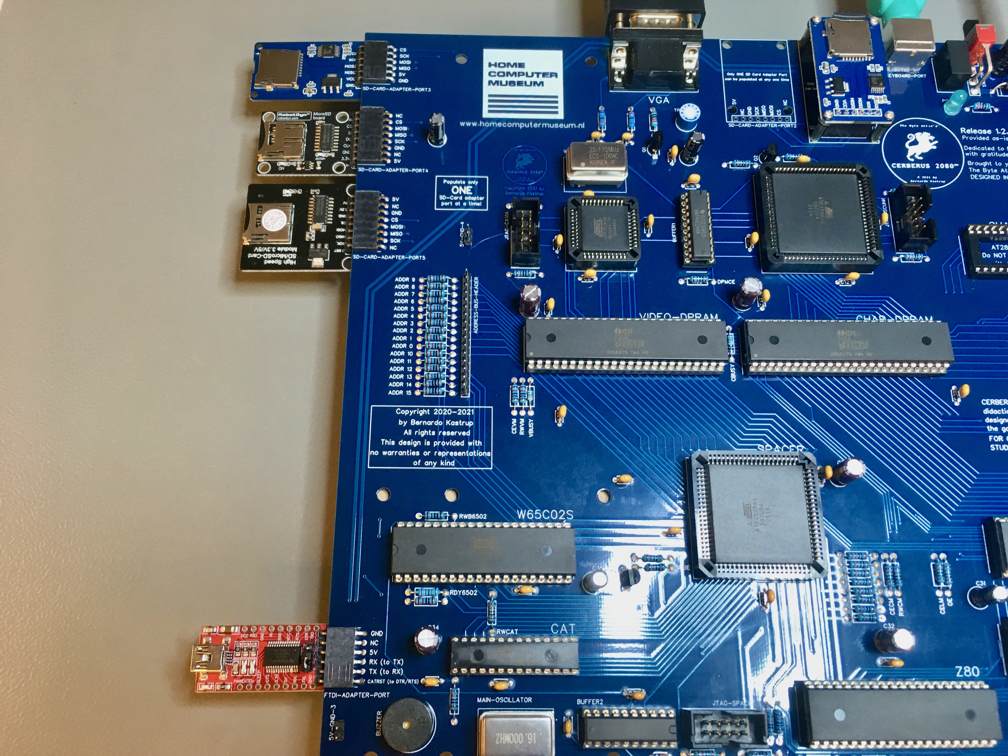
Photos/IMG_0669.jpeg
