TheByteAttic/CERBERUS2080/Photos/IMG_0671.jpeg

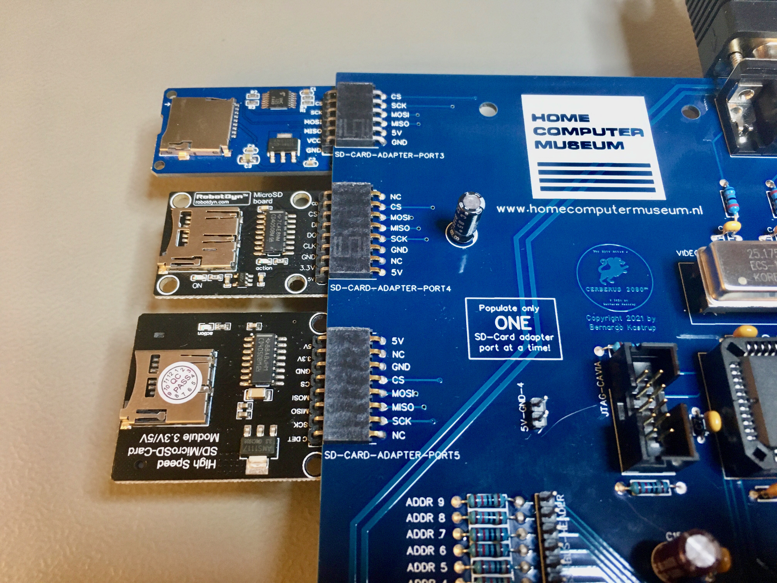
Photos/IMG_0671.jpeg
