TheByteAttic/CERBERUS2080/Photos/IMG_0672.jpeg

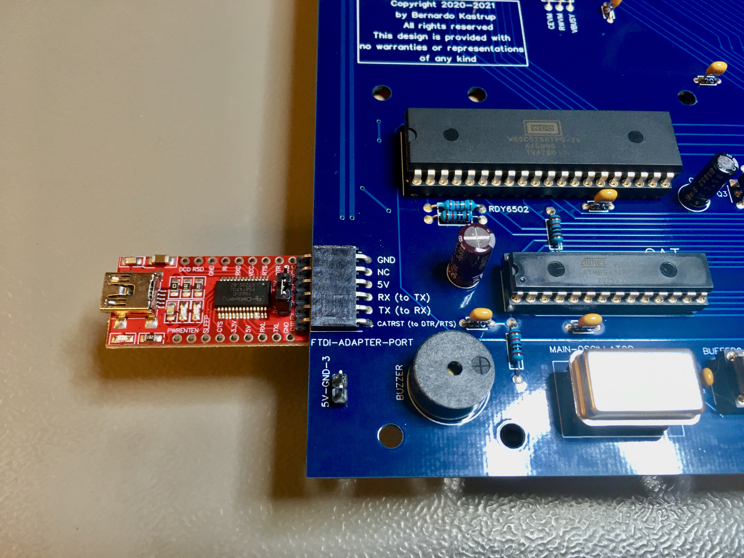
Photos/IMG_0672.jpeg
