TheByteAttic/CERBERUS2080/Photos/IMG_0677.jpg

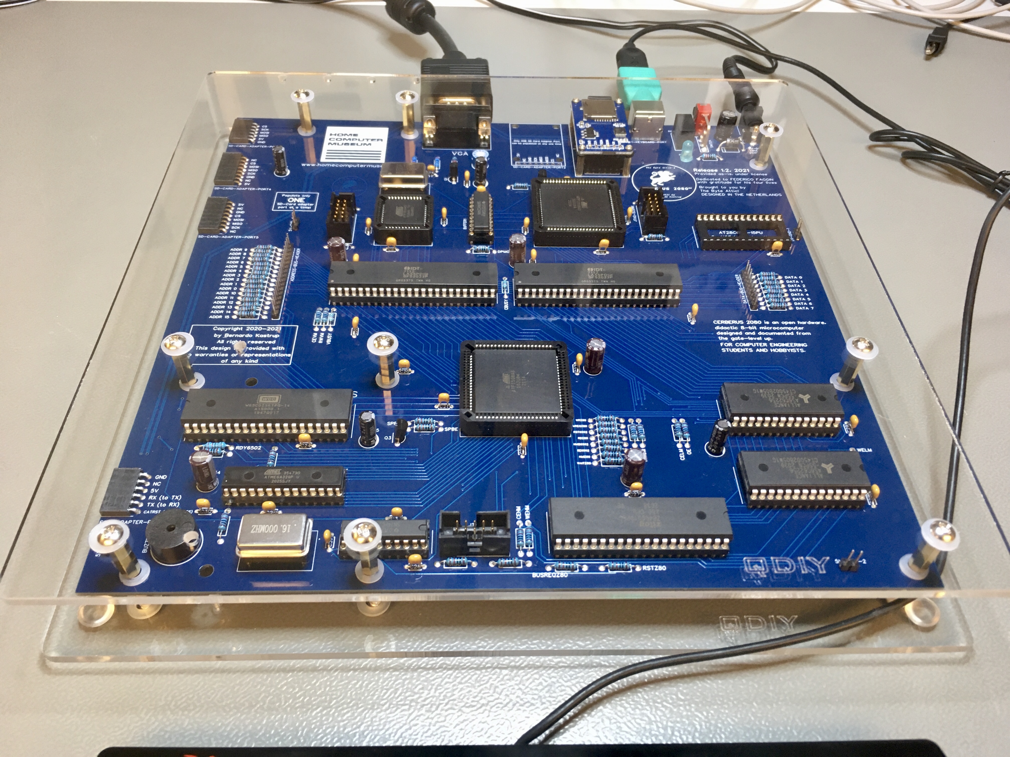
Photos/IMG_0677.jpg
