TheByteAttic/CERBERUS2080/Photos/IMG_0678.jpg

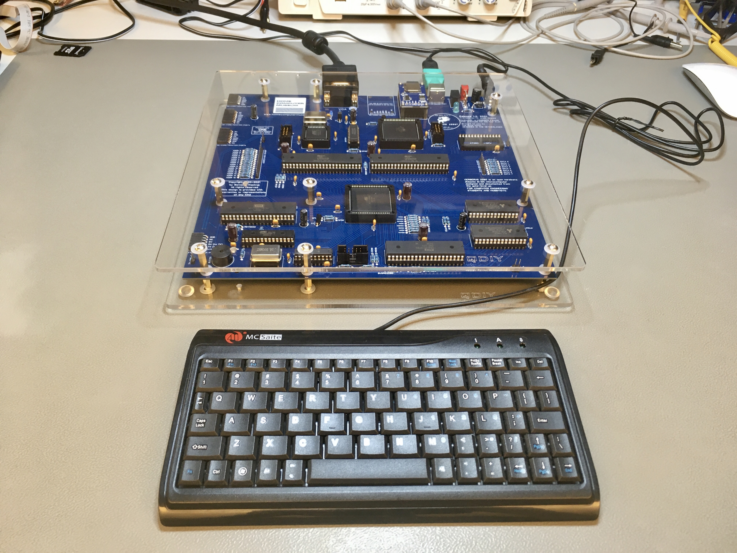
Photos/IMG_0678.jpg
