TheByteAttic/CERBERUS2080/Photos/IMG_0679.jpg

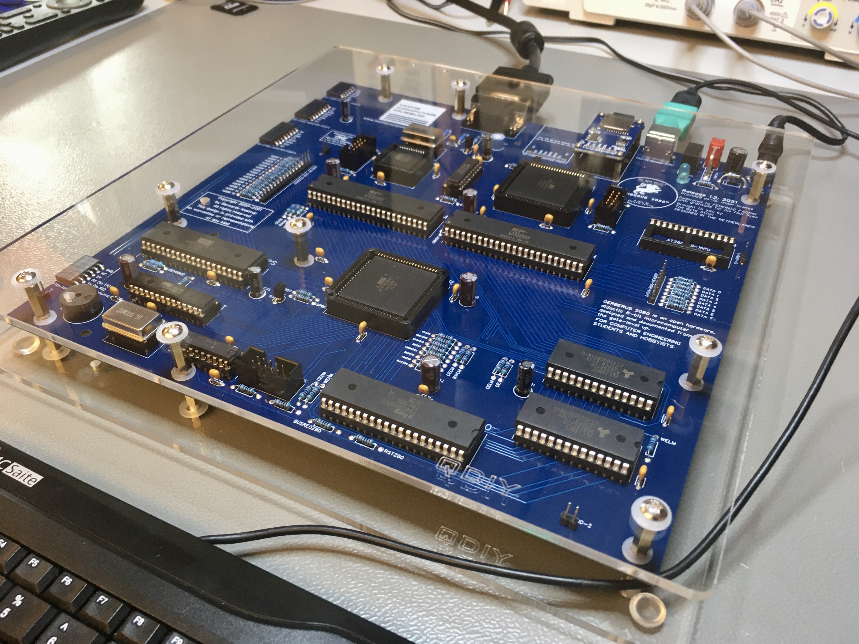
Photos/IMG_0679.jpg
