TheByteAttic/CERBERUS2080/Photos/IMG_0681.jpg

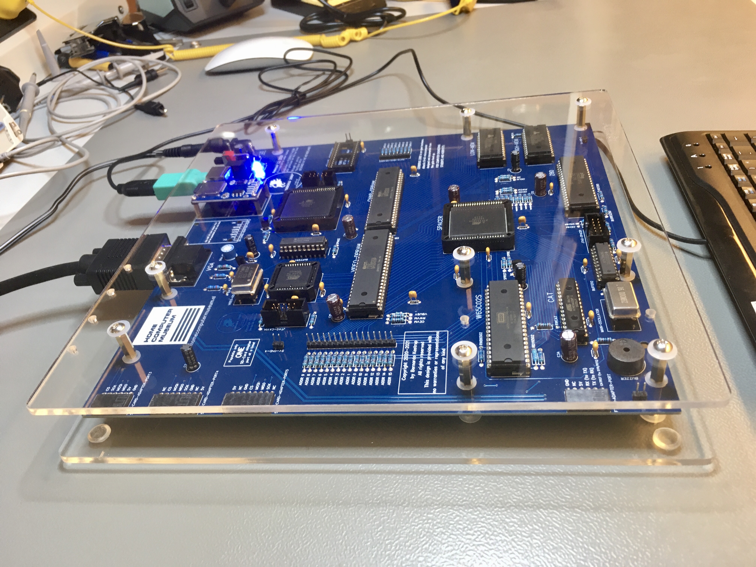
Photos/IMG_0681.jpg
