TheByteAttic/CERBERUS2080/Photos/IMG_0682.jpg

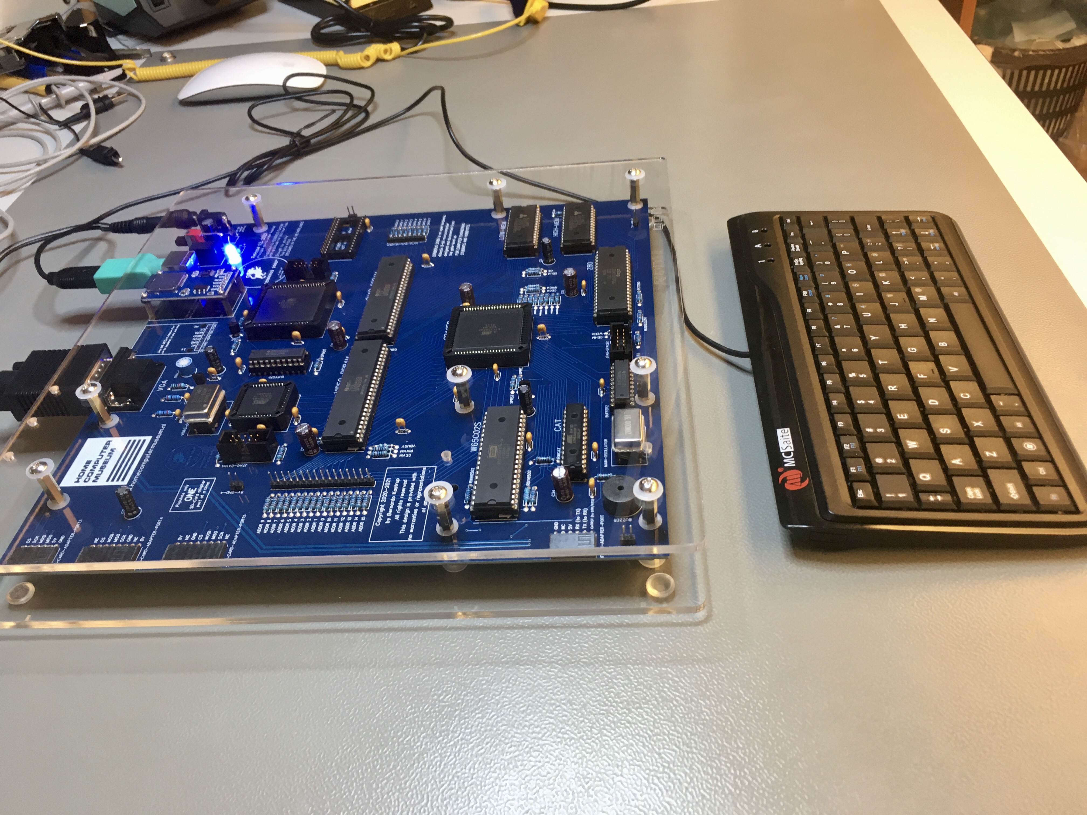
Photos/IMG_0682.jpg
