TheByteAttic/CERBERUS2080/Photos/IMG_0683.jpg

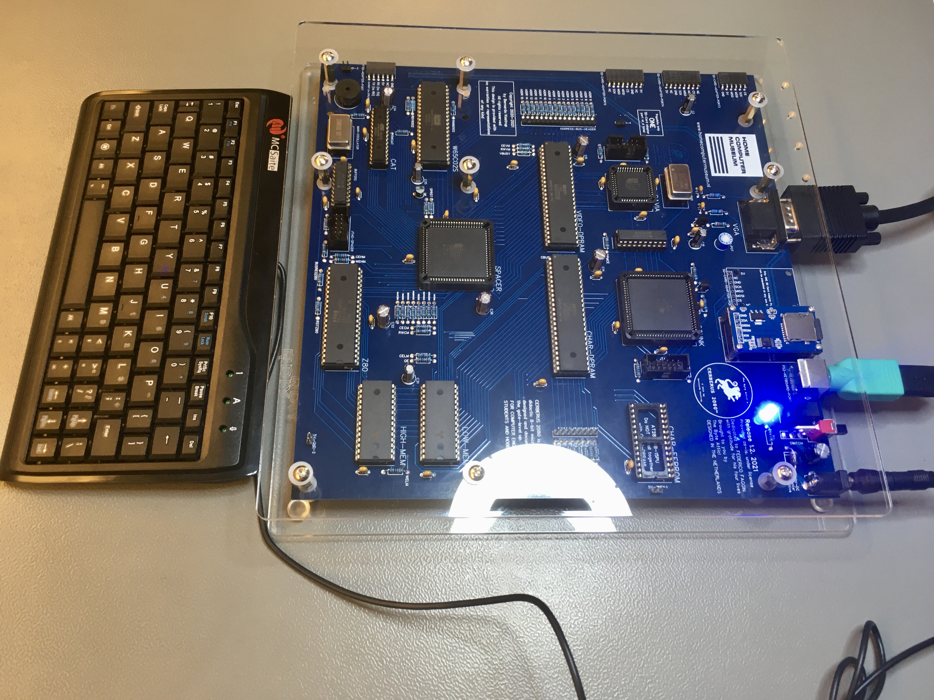
Photos/IMG_0683.jpg
