TheByteAttic/CERBERUS2080/Photos/IMG_0686.jpg

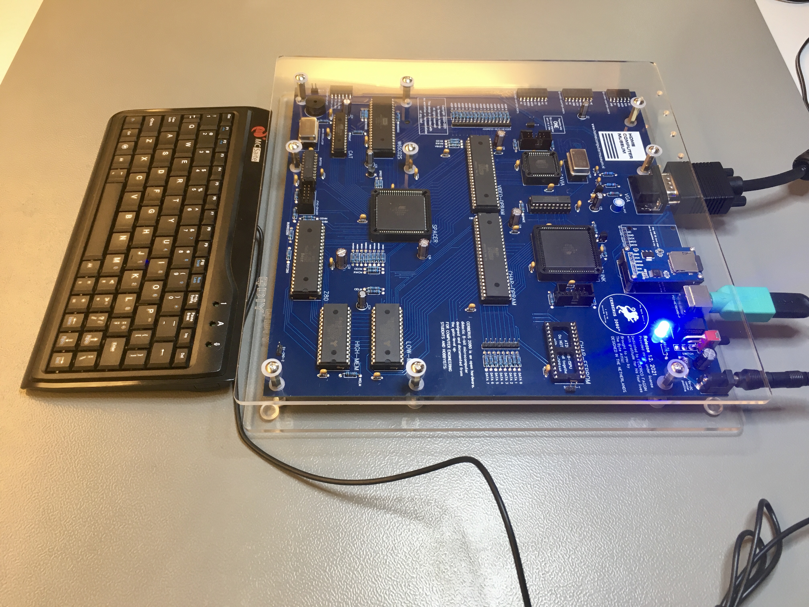
Photos/IMG_0686.jpg
