TheByteAttic/CERBERUS2080/Photos/IMG_0688.jpg

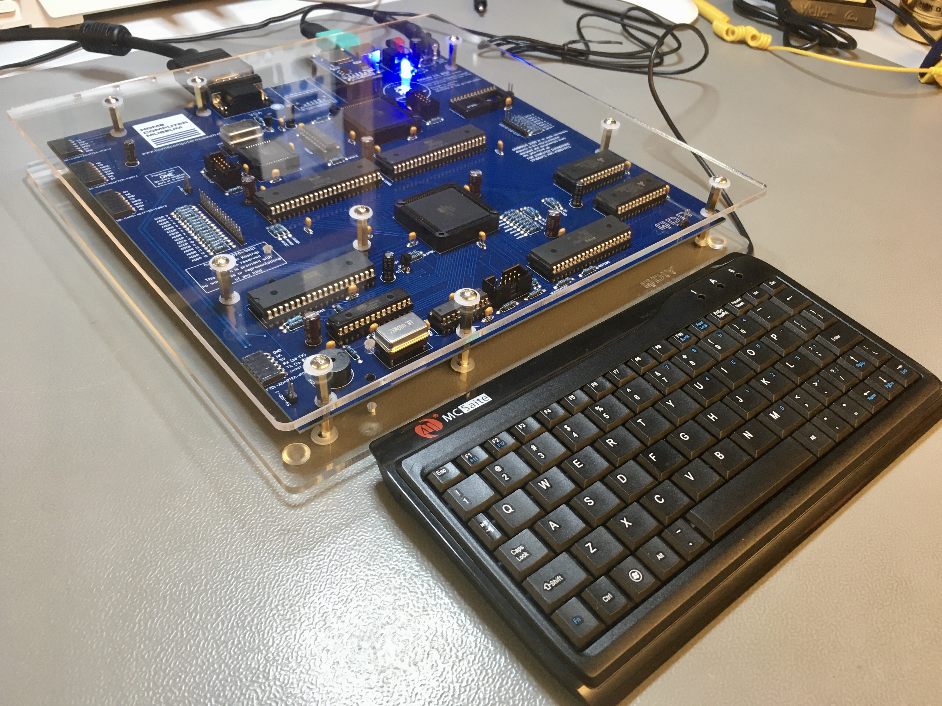
Photos/IMG_0688.jpg
