TheByteAttic/CERBERUS2080/Photos/IMG_0689.jpg

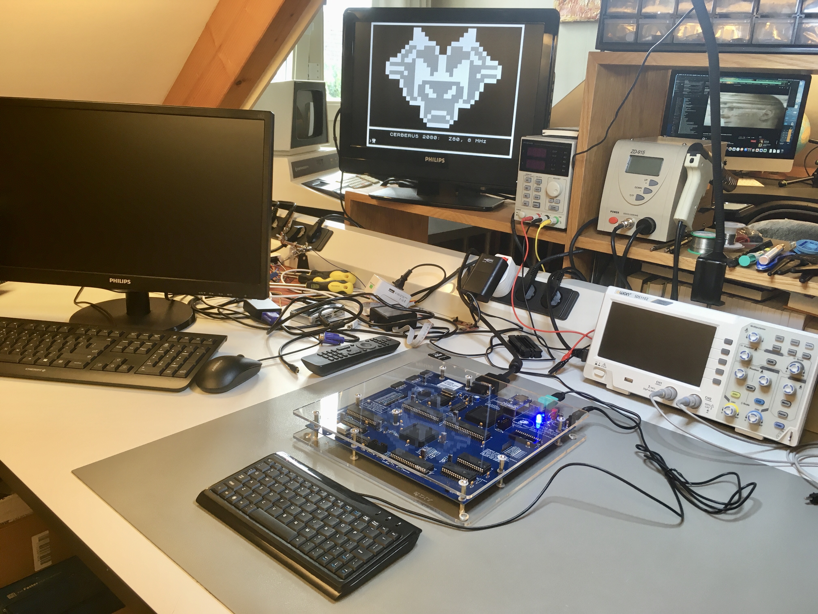
Photos/IMG_0689.jpg
