TheByteAttic/CERBERUS2080/Photos/IMG_0690.jpg

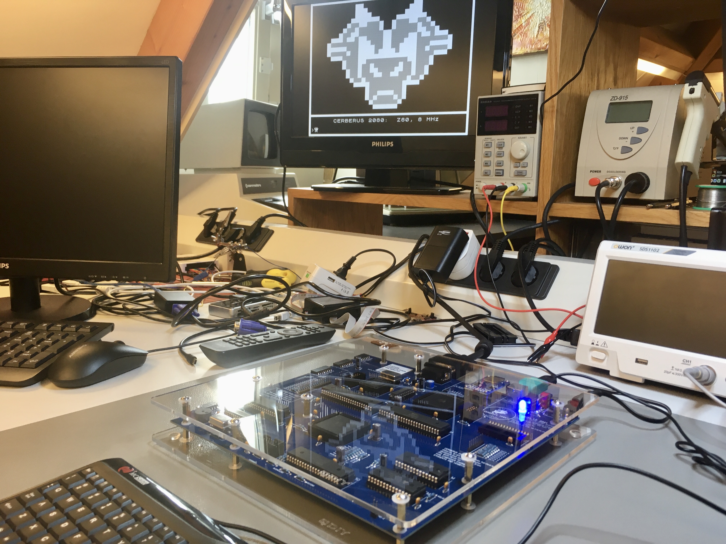
Photos/IMG_0690.jpg
