TheByteAttic/CERBERUS2080/Photos/IMG_0693.jpg

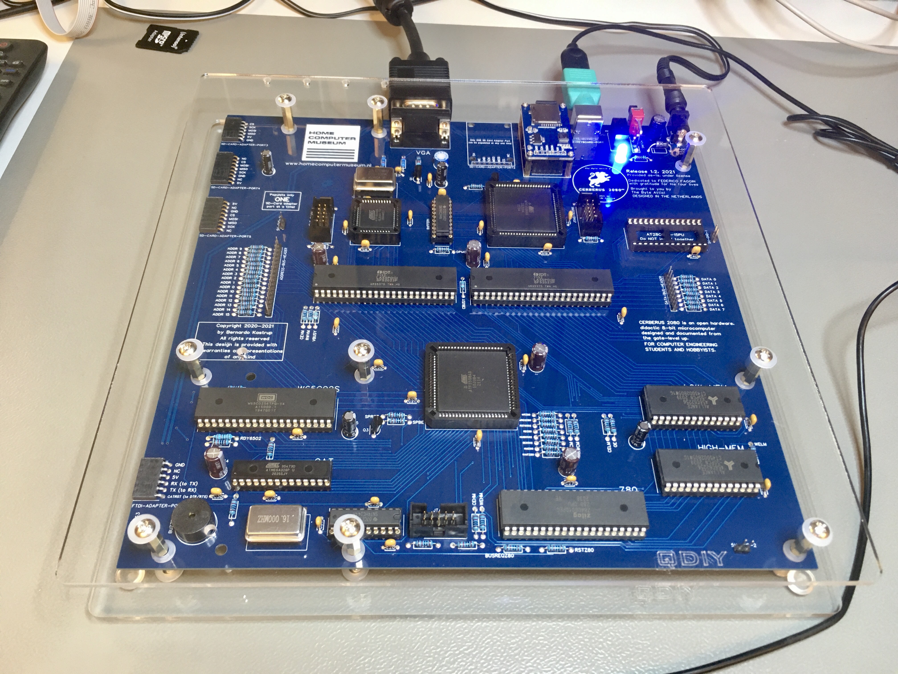
Photos/IMG_0693.jpg
