TheByteAttic/CERBERUS2080/Photos/IMG_0694.jpg

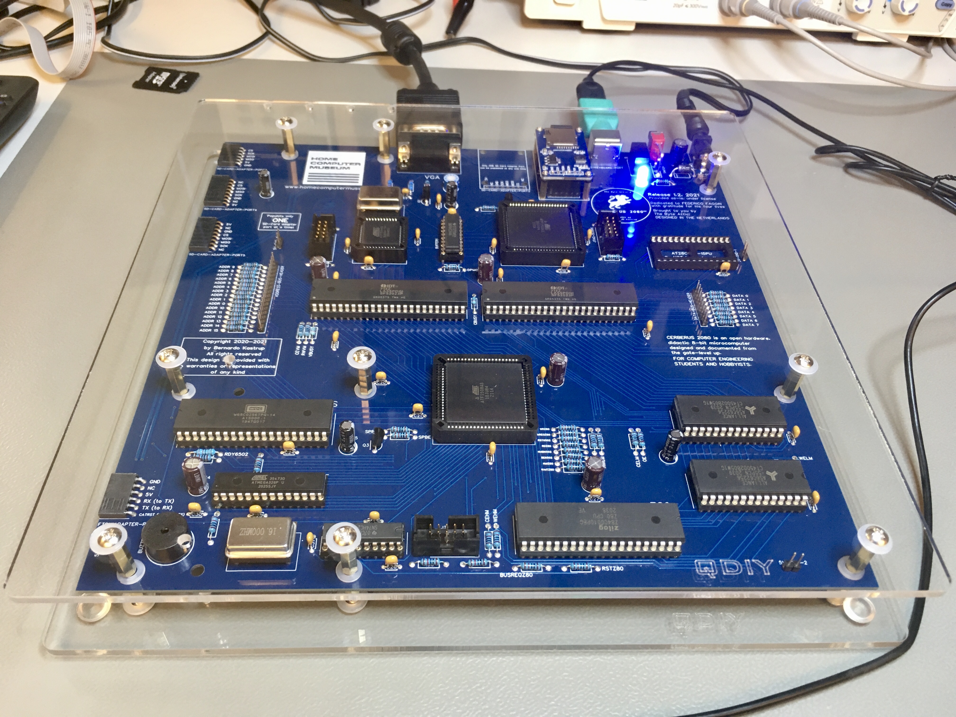
Photos/IMG_0694.jpg
