TheByteAttic/CERBERUS2080/Photos/IMG_0695.jpg

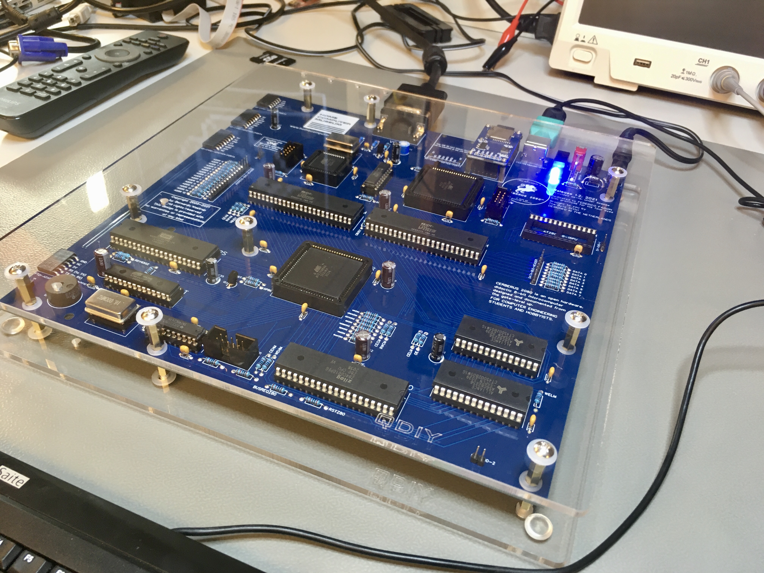
Photos/IMG_0695.jpg
