TheByteAttic/CERBERUS2080/Photos/IMG_0696.jpg

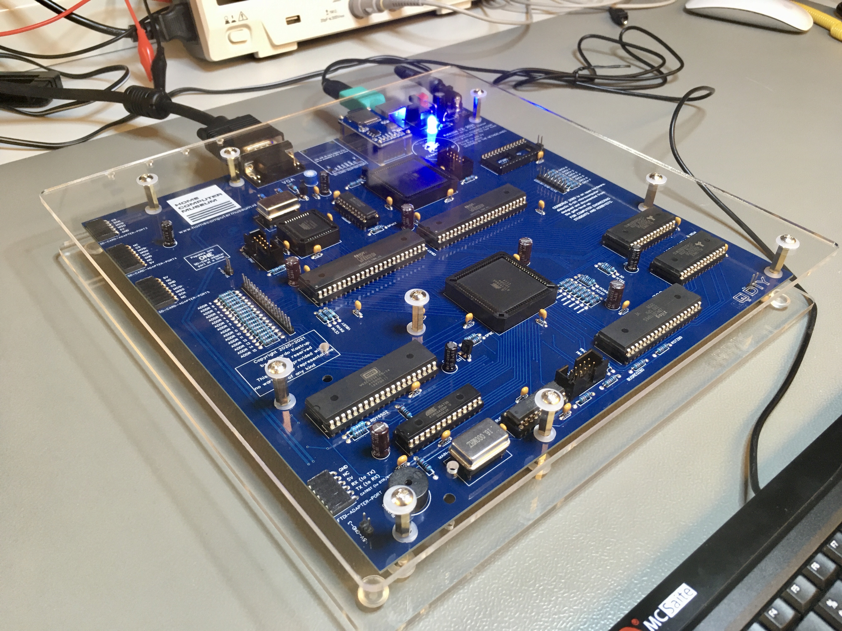
Photos/IMG_0696.jpg
