TheByteAttic/CERBERUS2080/CERBERUS 2080 Schematics and PCB/Schematic_CERBERUS 2080™_2021-08-29.pdf

A | A

## 7132LA55PDGI

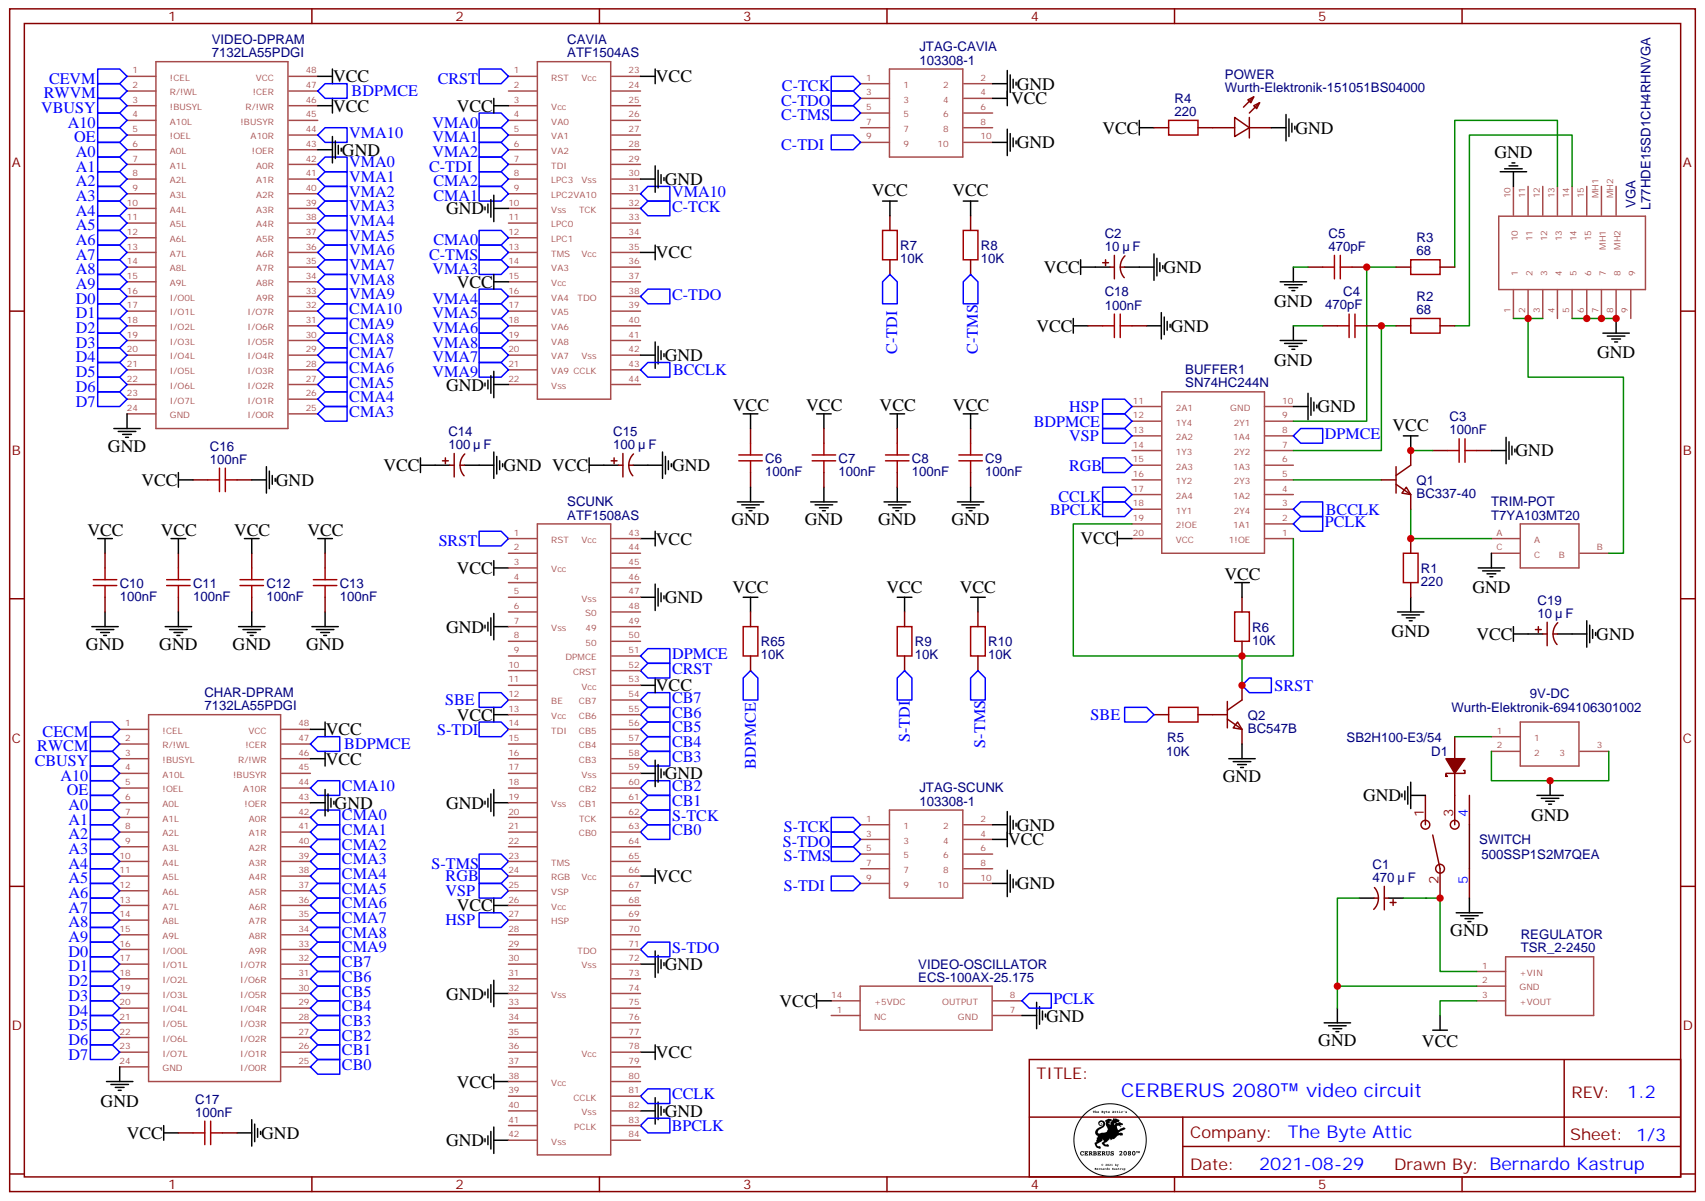
[picture p68: page 1]

Company: The Byte Attic

Drawn By: Bernardo Kastrup

A | A

## ATF1508AS

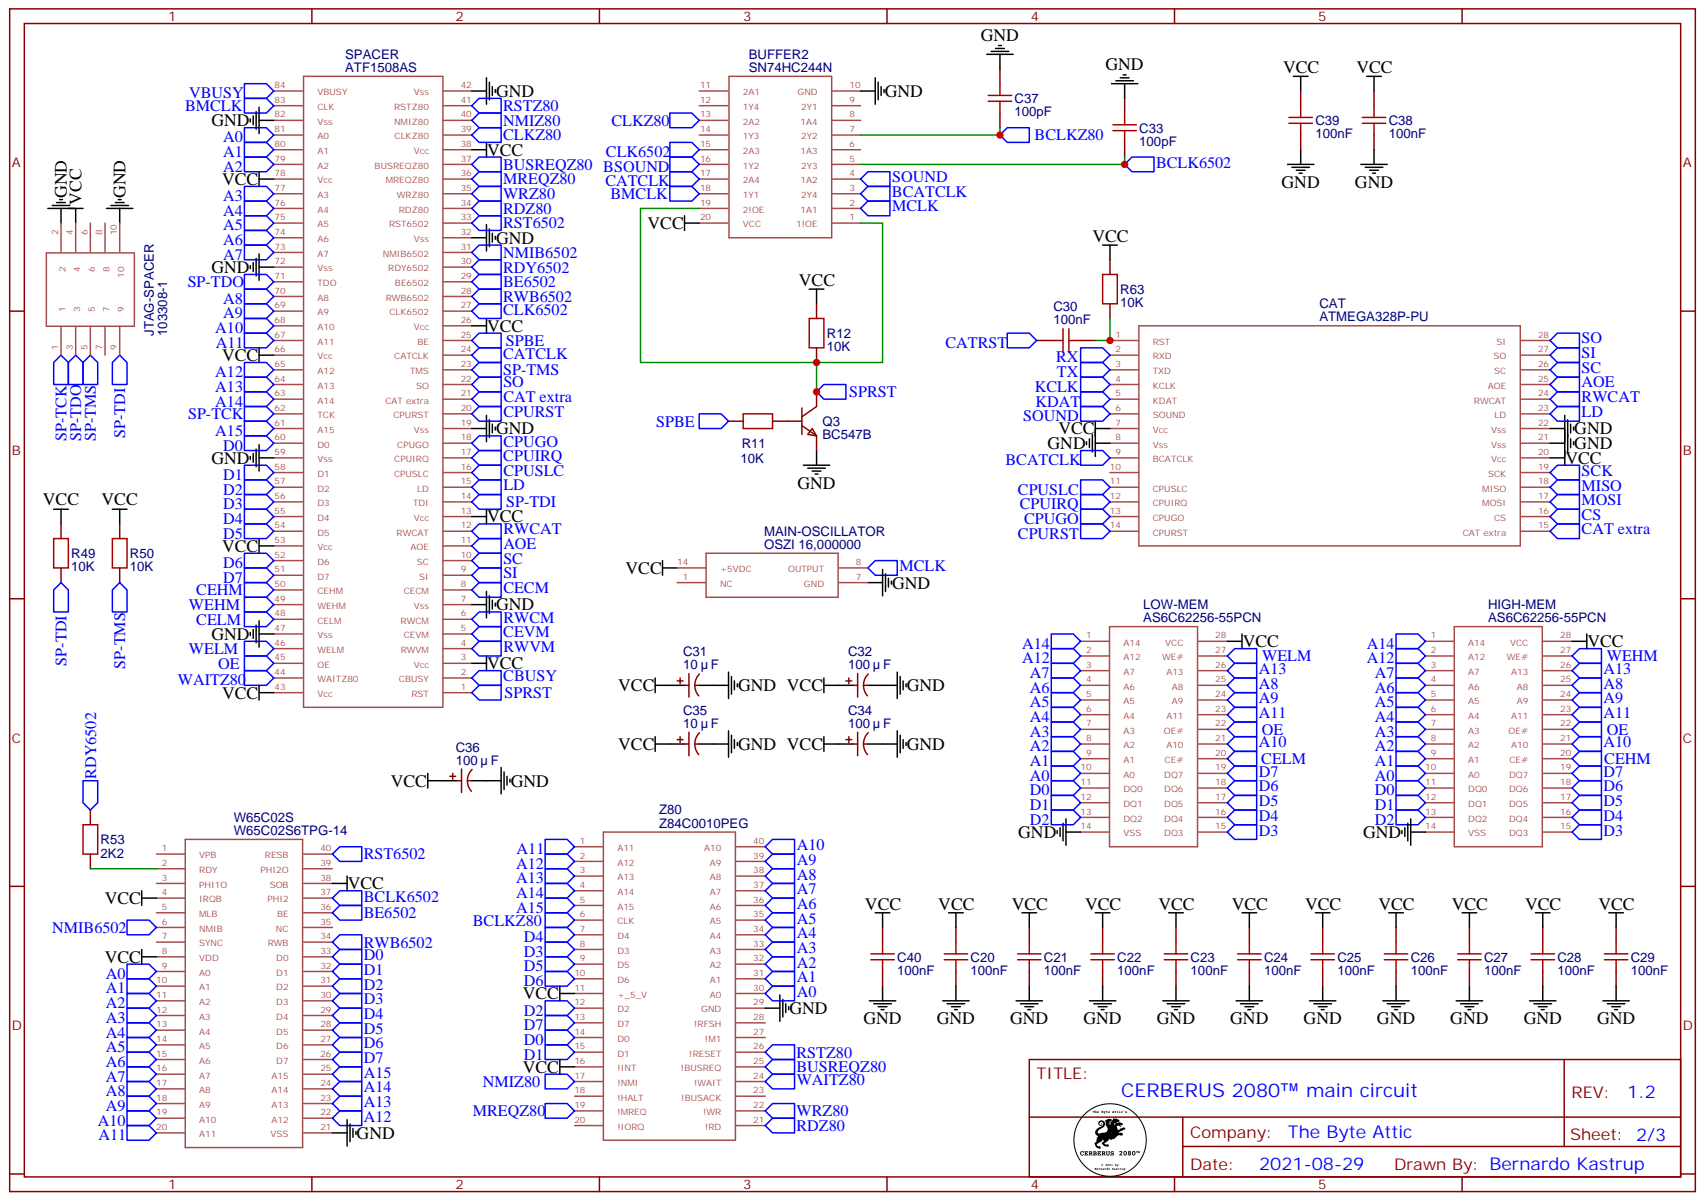
[picture p69: page 2]

A | A

10K

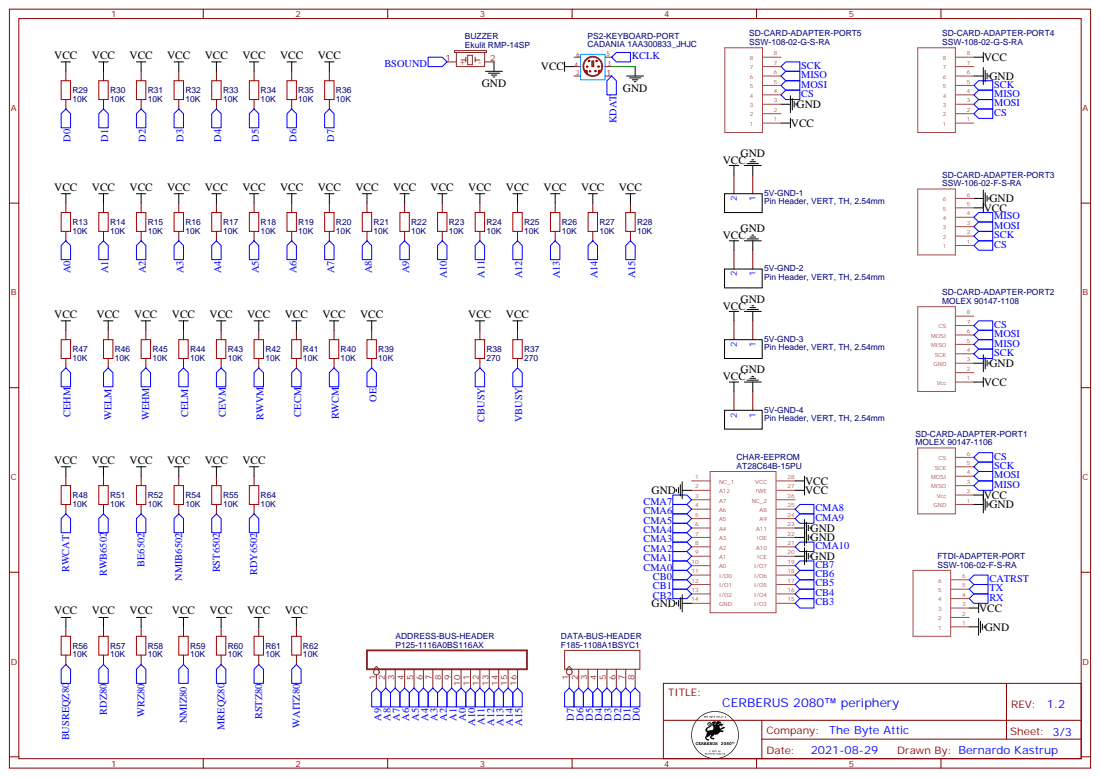
[picture p70: page 3]

VCC VCC VCC VCC

VCC VCC VCC VCC VCC VCC VCC VCC VCC VCC VCC VCC VCC VCC VCC VCC RDY⁶⁵⁰²

5V-GND-1
Pin Header, VERT, TH, 2.54mm

5V-GND-2

VCC VCC VCC

5V-GND-3

5V-GND-4
