TheByteAttic/CERBERUS2080/CERBERUS 2080 Schematics and PCB/PCB_SignalTraces_CERBERUS 2080 PCB_2021-08-29.pdf

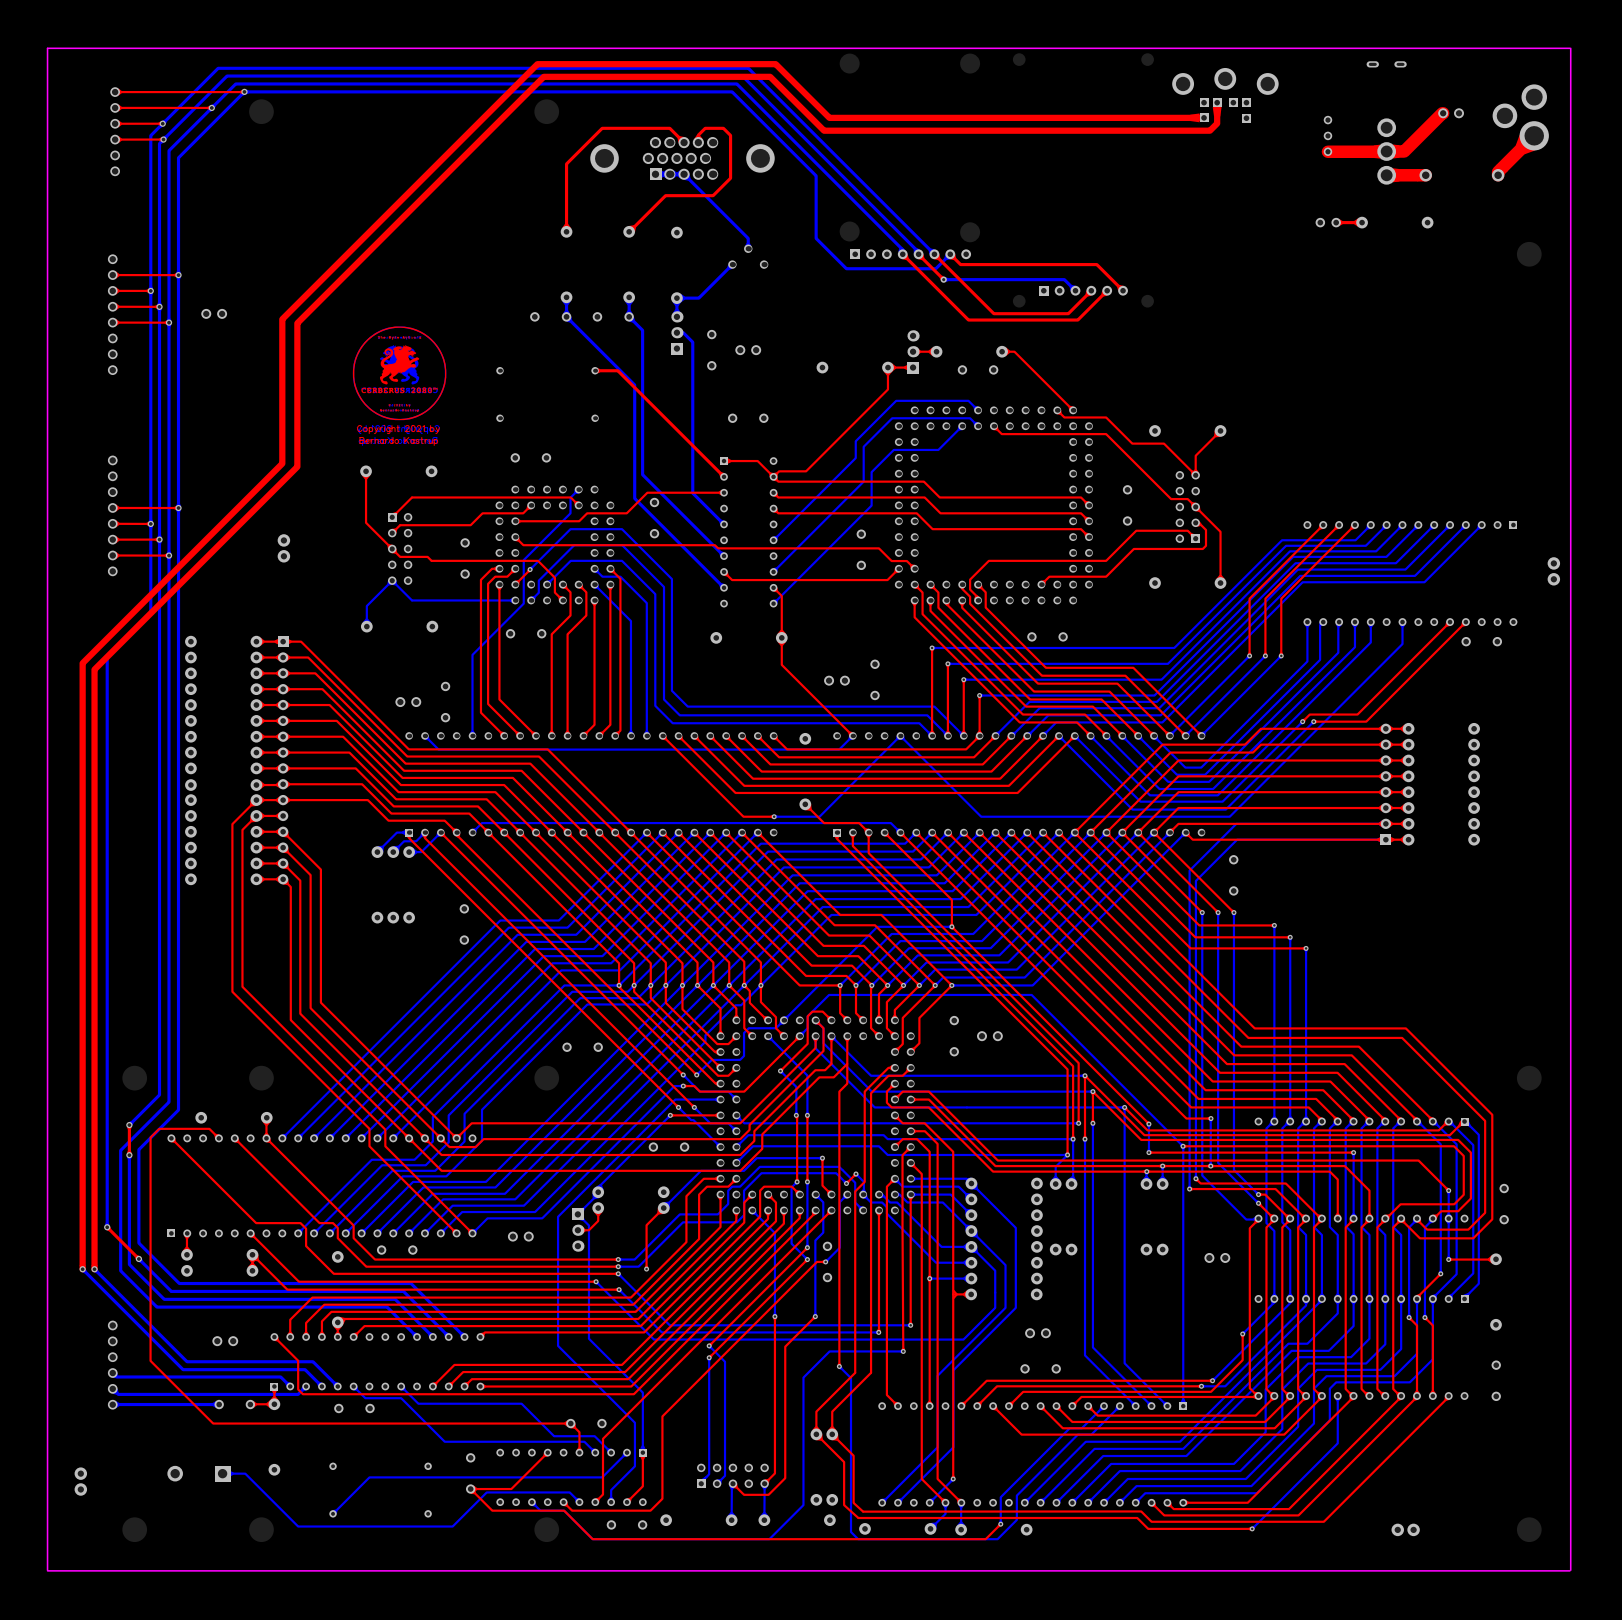
[picture p71: page 1]
