TheByteAttic/CERBERUS2080/(list of files, drawings)

Other design files:
CERBERUS 2080 EasyEDA design files/PCB_CERBERUS 2080 PCB_2021-08-29.json
CERBERUS 2080 EasyEDA design files/SCH_CERBERUS 2080™_2021-08-29.json
